Sasha7b9Work/A101/README.md

# Astra

## TOOLS

13.02.2025  
* Keil uVision 5.37.0, compiler 6.18 (при компиляции на 6.21 часто случаются зависания
  при определённых условиях (что-то вроде больших значений на входе, которые выходят за пределы экрана)

### SAST Tools

* [PVS-Studio](https://pvs-studio.ru/ru/pvs-studio/?utm_source=website&utm_medium=github&utm_campaign=open_source) - static analyzer for C, C++, C#, and Java code.
