Sasha7b9Work/A101/sources/Display/readme.txt

ASTRA_old.HMI - версия для первого дисплея
ASTRA.HIM - версия для второго (улучшенного) дисплея
