Sasha7b9Work/A101/docs/ТЗ/Команды.docx

При нажатии на экран приходит:

X, “+”, Y,”-“

| 1 (Page0)
01P_ | Кнопка выбора предела (2 mA) | AVP t11
02P_ | Кнопка выбора предела (20 mA) | AVP t12
03P_ | Кнопка выбора предела (200 mA) | AVP t13
04P_ | Кнопка выбора предела (2 A) | AVP t14
05P_ | Кнопка выбора предела (20 A) | AVP t15
06P_ | Кнопка выбора предела (50 A) | AVP t16
0A_ | Режим AVP
0DZ_ | Zero DC. Измеренное до этого значение постоянной составляющей тока принимается за ноль. | t5
0AZ_ | Zero AC. Измеренное до этого значение переменной составляющей тока принимается за ноль | t6
01I_ | Кнопка позволяющая выбрать дополнительные параметры сигнала максимальное значение. Imax. | t7
02I_ | Кнопка позволяющая выбрать дополнительные параметры сигнала минимальное значение. Imin. | t8
03I_ | Кнопка позволяющая выбрать дополнительные параметры сигнала значение от пика до пика. Ipp. | t9
04I_ | Кнопка позволяющая выбрать дополнительные параметры сигнала амплитудное значение. Iamp. | t10
0S_ | Signal. Hежим отображения графиков сигнала и спектра.
0C_ | Colibration
0DC_ | DC | t0
0AC_ | AC | t1
0AD_ | AC+DC | t1, t0
- | символ звездочки *. Он тухнет и зажигается каждые 1,5-2 секунды, что свидетельствует о том, что прибор исправно работает и информация до экрана доходит | t4

| 3 (Page1)
3WP_ | Отображение графика сигнала | s0
3SP_ | Отображение графика спектора | s0
3B0_ | Кнопка Назад с 3 -> 1

| 2 (Page2)
2B0_ | Кнопка Назад с 2 -> 1
21P_ | Кнопка выбора предела (2 mA)
22P_ | Кнопка выбора предела (20 mA)
23P_ | Кнопка выбора предела (200 mA)
24P_ | Кнопка выбора предела (2 A)
25P_ | Кнопка выбора предела (20 A)
26P_ | Кнопка выбора предела (50 A)
2D1_ | Клавиши выбора номера точки Dot 1
2D2_ | Клавиши выбора номера точки Dot 2
KB0_ | Клавиши цифровой клавиатуры: 0 | t1
KB1_ | Клавиши цифровой клавиатуры: 1 | t1
KB2_ | Клавиши цифровой клавиатуры: 2 | t1
KB3_ | Клавиши цифровой клавиатуры: 3 | t1
KB4_ | Клавиши цифровой клавиатуры: 4 | t1
KB5_ | Клавиши цифровой клавиатуры: 5 | t1
KB6_ | Клавиши цифровой клавиатуры: 6 | t1
KB7_ | Клавиши цифровой клавиатуры: 7 | t1
KB8_ | Клавиши цифровой клавиатуры: 8 | t1
KB9_ | Клавиши цифровой клавиатуры: 9 | t1
KBD_ | Клавиши запятой. | t1
KBS_ | Клавиши смены знака. | t6
- | Поле служит для вывода измеренных значений | t0
2SV_ | Нажать кнопку SAVE. В результате чего на основании ранее сохраненных значений рассчитываются необходимые коэффициенты калибровки для данного диапазона. Эти коэффициенты учитываются в режиме измерения
2OK_ | Нажать кнопку OK. В результате чего в памяти сохраняться значения силы тока измеренного и эталонного для данной точки
2DE_ | Переход на страницу отладки
| Page Debug
4B0_ | Назад – на страницу калибровки
