Sasha7b9Work/A101/docs/version_history.txt

- новая функциональность
* исправление
! схемные изменения

13.02.2025
    538
* Вернулись на версию 6.18 компилятора, потому что на 6.21 зависания

12.02.2025
    537
! Изменена полярность бита US9 PB14 PIN_ZERO. Последний номер прибора со старой полярностью - 17

21.09.2024
    0.1.110
- Правильно измеряются Imin, Imax, Ipp
    0.1.112
* Знаки дополнительных измерений правильно отрабатывают на дисплее
