Sasha7b9Work/A101/samples/arm_fir_example/ARMCM4_debug/arm_fir_example.htm

# Static Call Graph for image .\ARMCM4_debug\arm_fir_example.axf

#<CALLGRAPH># ARM Linker, 6160001: Last Updated: Mon Feb 12 09:05:09 2024

### Maximum Stack Usage = 216 bytes + Unknown(Functions without stacksize, Cycles, Untraceable Function Pointers)

### Call chain for Maximum Stack Depth:

__rt_entry_main ⇒ main ⇒ arm_snr_f32 ⇒ __hardfp_log10 ⇒ log ⇒ __hardfp_log ⇒ __kernel_poly ⇒ __aeabi_dmul

### Functions with no stack information

- __user_initial_stackheap

### Mutually Recursive functions

- NMI_Handler ⇒ NMI_Handler
- HardFault_Handler ⇒ HardFault_Handler
- MemManage_Handler ⇒ MemManage_Handler
- BusFault_Handler ⇒ BusFault_Handler
- UsageFault_Handler ⇒ UsageFault_Handler
- SVC_Handler ⇒ SVC_Handler
- DebugMon_Handler ⇒ DebugMon_Handler
- PendSV_Handler ⇒ PendSV_Handler
- SysTick_Handler ⇒ SysTick_Handler
- ADC_IRQHandler ⇒ ADC_IRQHandler

### Function Pointers

- ADC_IRQHandler from startup_stm32f407xx.o(.text) referenced from startup_stm32f407xx.o(RESET)
- BusFault_Handler from startup_stm32f407xx.o(.text) referenced from startup_stm32f407xx.o(RESET)
- CAN1_RX0_IRQHandler from startup_stm32f407xx.o(.text) referenced from startup_stm32f407xx.o(RESET)
- CAN1_RX1_IRQHandler from startup_stm32f407xx.o(.text) referenced from startup_stm32f407xx.o(RESET)
- CAN1_SCE_IRQHandler from startup_stm32f407xx.o(.text) referenced from startup_stm32f407xx.o(RESET)
- CAN1_TX_IRQHandler from startup_stm32f407xx.o(.text) referenced from startup_stm32f407xx.o(RESET)
- CAN2_RX0_IRQHandler from startup_stm32f407xx.o(.text) referenced from startup_stm32f407xx.o(RESET)
- CAN2_RX1_IRQHandler from startup_stm32f407xx.o(.text) referenced from startup_stm32f407xx.o(RESET)
- CAN2_SCE_IRQHandler from startup_stm32f407xx.o(.text) referenced from startup_stm32f407xx.o(RESET)
- CAN2_TX_IRQHandler from startup_stm32f407xx.o(.text) referenced from startup_stm32f407xx.o(RESET)
- DCMI_IRQHandler from startup_stm32f407xx.o(.text) referenced from startup_stm32f407xx.o(RESET)
- DMA1_Stream0_IRQHandler from startup_stm32f407xx.o(.text) referenced from startup_stm32f407xx.o(RESET)
- DMA1_Stream1_IRQHandler from startup_stm32f407xx.o(.text) referenced from startup_stm32f407xx.o(RESET)
- DMA1_Stream2_IRQHandler from startup_stm32f407xx.o(.text) referenced from startup_stm32f407xx.o(RESET)
- DMA1_Stream3_IRQHandler from startup_stm32f407xx.o(.text) referenced from startup_stm32f407xx.o(RESET)
- DMA1_Stream4_IRQHandler from startup_stm32f407xx.o(.text) referenced from startup_stm32f407xx.o(RESET)
- DMA1_Stream5_IRQHandler from startup_stm32f407xx.o(.text) referenced from startup_stm32f407xx.o(RESET)
- DMA1_Stream6_IRQHandler from startup_stm32f407xx.o(.text) referenced from startup_stm32f407xx.o(RESET)
- DMA1_Stream7_IRQHandler from startup_stm32f407xx.o(.text) referenced from startup_stm32f407xx.o(RESET)
- DMA2_Stream0_IRQHandler from startup_stm32f407xx.o(.text) referenced from startup_stm32f407xx.o(RESET)
- DMA2_Stream1_IRQHandler from startup_stm32f407xx.o(.text) referenced from startup_stm32f407xx.o(RESET)
- DMA2_Stream2_IRQHandler from startup_stm32f407xx.o(.text) referenced from startup_stm32f407xx.o(RESET)
- DMA2_Stream3_IRQHandler from startup_stm32f407xx.o(.text) referenced from startup_stm32f407xx.o(RESET)
- DMA2_Stream4_IRQHandler from startup_stm32f407xx.o(.text) referenced from startup_stm32f407xx.o(RESET)
- DMA2_Stream5_IRQHandler from startup_stm32f407xx.o(.text) referenced from startup_stm32f407xx.o(RESET)
- DMA2_Stream6_IRQHandler from startup_stm32f407xx.o(.text) referenced from startup_stm32f407xx.o(RESET)
- DMA2_Stream7_IRQHandler from startup_stm32f407xx.o(.text) referenced from startup_stm32f407xx.o(RESET)
- DebugMon_Handler from startup_stm32f407xx.o(.text) referenced from startup_stm32f407xx.o(RESET)
- ETH_IRQHandler from startup_stm32f407xx.o(.text) referenced from startup_stm32f407xx.o(RESET)
- ETH_WKUP_IRQHandler from startup_stm32f407xx.o(.text) referenced from startup_stm32f407xx.o(RESET)
- EXTI0_IRQHandler from startup_stm32f407xx.o(.text) referenced from startup_stm32f407xx.o(RESET)
- EXTI15_10_IRQHandler from startup_stm32f407xx.o(.text) referenced from startup_stm32f407xx.o(RESET)
- EXTI1_IRQHandler from startup_stm32f407xx.o(.text) referenced from startup_stm32f407xx.o(RESET)
- EXTI2_IRQHandler from startup_stm32f407xx.o(.text) referenced from startup_stm32f407xx.o(RESET)
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
- TIM4_IRQHandler from startup_stm32f407xx.o(.text) referenced from startup_stm32f407xx.o(RESET)
- TIM5_IRQHandler from startup_stm32f407xx.o(.text) referenced from startup_stm32f407xx.o(RESET)
- TIM6_DAC_IRQHandler from startup_stm32f407xx.o(.text) referenced from startup_stm32f407xx.o(RESET)
- TIM7_IRQHandler from startup_stm32f407xx.o(.text) referenced from startup_stm32f407xx.o(RESET)
- TIM8_BRK_TIM12_IRQHandler from startup_stm32f407xx.o(.text) referenced from startup_stm32f407xx.o(RESET)
- TIM8_CC_IRQHandler from startup_stm32f407xx.o(.text) referenced from startup_stm32f407xx.o(RESET)
- TIM8_TRG_COM_TIM14_IRQHandler from startup_stm32f407xx.o(.text) referenced from startup_stm32f407xx.o(RESET)
- TIM8_UP_TIM13_IRQHandler from startup_stm32f407xx.o(.text) referenced from startup_stm32f407xx.o(RESET)
- UART4_IRQHandler from startup_stm32f407xx.o(.text) referenced from startup_stm32f407xx.o(RESET)
- UART5_IRQHandler from startup_stm32f407xx.o(.text) referenced from startup_stm32f407xx.o(RESET)
- USART1_IRQHandler from startup_stm32f407xx.o(.text) referenced from startup_stm32f407xx.o(RESET)
- USART2_IRQHandler from startup_stm32f407xx.o(.text) referenced from startup_stm32f407xx.o(RESET)
- USART3_IRQHandler from startup_stm32f407xx.o(.text) referenced from startup_stm32f407xx.o(RESET)
- USART6_IRQHandler from startup_stm32f407xx.o(.text) referenced from startup_stm32f407xx.o(RESET)
- UsageFault_Handler from startup_stm32f407xx.o(.text) referenced from startup_stm32f407xx.o(RESET)
- WWDG_IRQHandler from startup_stm32f407xx.o(.text) referenced from startup_stm32f407xx.o(RESET)
- __main from __main.o(!!!main) referenced from startup_stm32f407xx.o(.text)

### Global Symbols

__main (Thumb, 8 bytes, Stack size 0 bytes, __main.o(!!!main))

[Calls]

- >> __scatterload
- >> __rt_entry

[Address Reference Count : 1]

- startup_stm32f407xx.o(.text)

__scatterload (Thumb, 0 bytes, Stack size unknown bytes, __scatter.o(!!!scatter))

[Called By]

- >> __main

__scatterload_rt2 (Thumb, 44 bytes, Stack size unknown bytes, __scatter.o(!!!scatter), UNUSED)

[Calls]

- >> __rt_entry

__scatterload_rt2_thumb_only (Thumb, 0 bytes, Stack size unknown bytes, __scatter.o(!!!scatter), UNUSED)

__scatterload_null (Thumb, 0 bytes, Stack size unknown bytes, __scatter.o(!!!scatter), UNUSED)

__decompress (Thumb, 100 bytes, Stack size unknown bytes, __dclz77c.o(!!dclz77c), UNUSED)

__decompress2 (Thumb, 0 bytes, Stack size unknown bytes, __dclz77c.o(!!dclz77c), UNUSED)

__scatterload_zeroinit (Thumb, 28 bytes, Stack size unknown bytes, __scatter_zi.o(!!handler_zi), UNUSED)

__rt_lib_init (Thumb, 0 bytes, Stack size unknown bytes, libinit.o(.ARM.Collect$$libinit$$00000000))

[Called By]

- >> __rt_entry_li

__rt_lib_init_fp_1 (Thumb, 0 bytes, Stack size unknown bytes, libinit2.o(.ARM.Collect$$libinit$$00000001))

[Calls]

- >> _fp_init

__rt_lib_init_alloca_1 (Thumb, 0 bytes, Stack size unknown bytes, libinit2.o(.ARM.Collect$$libinit$$0000002E))

__rt_lib_init_argv_1 (Thumb, 0 bytes, Stack size unknown bytes, libinit2.o(.ARM.Collect$$libinit$$0000002C))

__rt_lib_init_atexit_1 (Thumb, 0 bytes, Stack size unknown bytes, libinit2.o(.ARM.Collect$$libinit$$0000001B))

__rt_lib_init_clock_1 (Thumb, 0 bytes, Stack size unknown bytes, libinit2.o(.ARM.Collect$$libinit$$00000021))

__rt_lib_init_cpp_1 (Thumb, 0 bytes, Stack size unknown bytes, libinit2.o(.ARM.Collect$$libinit$$00000032))

__rt_lib_init_exceptions_1 (Thumb, 0 bytes, Stack size unknown bytes, libinit2.o(.ARM.Collect$$libinit$$00000030))

__rt_lib_init_fp_trap_1 (Thumb, 0 bytes, Stack size unknown bytes, libinit2.o(.ARM.Collect$$libinit$$0000001F))

__rt_lib_init_getenv_1 (Thumb, 0 bytes, Stack size unknown bytes, libinit2.o(.ARM.Collect$$libinit$$00000023))

__rt_lib_init_heap_1 (Thumb, 0 bytes, Stack size unknown bytes, libinit2.o(.ARM.Collect$$libinit$$0000000A))

__rt_lib_init_lc_collate_1 (Thumb, 0 bytes, Stack size unknown bytes, libinit2.o(.ARM.Collect$$libinit$$00000011))

__rt_lib_init_lc_ctype_1 (Thumb, 0 bytes, Stack size unknown bytes, libinit2.o(.ARM.Collect$$libinit$$00000013))

__rt_lib_init_lc_monetary_1 (Thumb, 0 bytes, Stack size unknown bytes, libinit2.o(.ARM.Collect$$libinit$$00000015))

__rt_lib_init_lc_numeric_1 (Thumb, 0 bytes, Stack size unknown bytes, libinit2.o(.ARM.Collect$$libinit$$00000017))

__rt_lib_init_lc_time_1 (Thumb, 0 bytes, Stack size unknown bytes, libinit2.o(.ARM.Collect$$libinit$$00000019))

__rt_lib_init_preinit_1 (Thumb, 0 bytes, Stack size unknown bytes, libinit2.o(.ARM.Collect$$libinit$$00000004))

__rt_lib_init_rand_1 (Thumb, 0 bytes, Stack size unknown bytes, libinit2.o(.ARM.Collect$$libinit$$0000000E))

__rt_lib_init_return (Thumb, 0 bytes, Stack size unknown bytes, libinit2.o(.ARM.Collect$$libinit$$00000033))

__rt_lib_init_signal_1 (Thumb, 0 bytes, Stack size unknown bytes, libinit2.o(.ARM.Collect$$libinit$$0000001D))

__rt_lib_init_stdio_1 (Thumb, 0 bytes, Stack size unknown bytes, libinit2.o(.ARM.Collect$$libinit$$00000025))

__rt_lib_init_user_alloc_1 (Thumb, 0 bytes, Stack size unknown bytes, libinit2.o(.ARM.Collect$$libinit$$0000000C))

__rt_lib_shutdown (Thumb, 0 bytes, Stack size unknown bytes, libshutdown.o(.ARM.Collect$$libshutdown$$00000000))

[Called By]

- >> __rt_exit_ls

__rt_lib_shutdown_cpp_1 (Thumb, 0 bytes, Stack size unknown bytes, libshutdown2.o(.ARM.Collect$$libshutdown$$00000002))

__rt_lib_shutdown_fp_trap_1 (Thumb, 0 bytes, Stack size unknown bytes, libshutdown2.o(.ARM.Collect$$libshutdown$$00000007))

__rt_lib_shutdown_heap_1 (Thumb, 0 bytes, Stack size unknown bytes, libshutdown2.o(.ARM.Collect$$libshutdown$$0000000F))

__rt_lib_shutdown_return (Thumb, 0 bytes, Stack size unknown bytes, libshutdown2.o(.ARM.Collect$$libshutdown$$00000010))

__rt_lib_shutdown_signal_1 (Thumb, 0 bytes, Stack size unknown bytes, libshutdown2.o(.ARM.Collect$$libshutdown$$0000000A))

__rt_lib_shutdown_stdio_1 (Thumb, 0 bytes, Stack size unknown bytes, libshutdown2.o(.ARM.Collect$$libshutdown$$00000004))

__rt_lib_shutdown_user_alloc_1 (Thumb, 0 bytes, Stack size unknown bytes, libshutdown2.o(.ARM.Collect$$libshutdown$$0000000C))

__rt_entry (Thumb, 0 bytes, Stack size unknown bytes, __rtentry.o(.ARM.Collect$$rtentry$$00000000))

[Called By]

- >> __scatterload_rt2
- >> __main

__rt_entry_presh_1 (Thumb, 0 bytes, Stack size unknown bytes, __rtentry2.o(.ARM.Collect$$rtentry$$00000002))

__rt_entry_sh (Thumb, 0 bytes, Stack size unknown bytes, __rtentry4.o(.ARM.Collect$$rtentry$$00000004))

[Stack]

- Max Depth = 8 + Unknown Stack Size
- Call Chain = __rt_entry_sh ⇒ __user_setup_stackheap

[Calls]

- >> __user_setup_stackheap

__rt_entry_li (Thumb, 0 bytes, Stack size unknown bytes, __rtentry2.o(.ARM.Collect$$rtentry$$0000000A))

[Calls]

- >> __rt_lib_init

__rt_entry_postsh_1 (Thumb, 0 bytes, Stack size unknown bytes, __rtentry2.o(.ARM.Collect$$rtentry$$00000009))

__rt_entry_main (Thumb, 0 bytes, Stack size unknown bytes, __rtentry2.o(.ARM.Collect$$rtentry$$0000000D))

[Stack]

- Max Depth = 216 + Unknown Stack Size
- Call Chain = __rt_entry_main ⇒ main ⇒ arm_snr_f32 ⇒ __hardfp_log10 ⇒ log ⇒ __hardfp_log ⇒ __kernel_poly ⇒ __aeabi_dmul

[Calls]

- >> exit
- >> main

__rt_entry_postli_1 (Thumb, 0 bytes, Stack size unknown bytes, __rtentry2.o(.ARM.Collect$$rtentry$$0000000C))

__rt_exit (Thumb, 0 bytes, Stack size unknown bytes, rtexit.o(.ARM.Collect$$rtexit$$00000000))

[Called By]

- >> exit

__rt_exit_ls (Thumb, 0 bytes, Stack size unknown bytes, rtexit2.o(.ARM.Collect$$rtexit$$00000003))

[Calls]

- >> __rt_lib_shutdown

__rt_exit_prels_1 (Thumb, 0 bytes, Stack size unknown bytes, rtexit2.o(.ARM.Collect$$rtexit$$00000002))

__rt_exit_exit (Thumb, 0 bytes, Stack size unknown bytes, rtexit2.o(.ARM.Collect$$rtexit$$00000004))

[Calls]

- >> _sys_exit

arm_snr_f32 (Thumb, 164 bytes, Stack size 8 bytes, math_helper.o(.text))

[Stack]

- Max Depth = 200
- Call Chain = arm_snr_f32 ⇒ __hardfp_log10 ⇒ log ⇒ __hardfp_log ⇒ __kernel_poly ⇒ __aeabi_dmul

[Calls]

- >> __hardfp_log10
- >> __aeabi_f2d
- >> __aeabi_dmul
- >> __aeabi_d2f

[Called By]

- >> main

arm_provide_guard_bits_q15 (Thumb, 24 bytes, Stack size 0 bytes, math_helper.o(.text), UNUSED)

arm_float_to_q12_20 (Thumb, 140 bytes, Stack size 56 bytes, math_helper.o(.text), UNUSED)

[Calls]

- >> __aeabi_i2d
- >> __aeabi_d2iz
- >> __aeabi_dadd

arm_compare_fixed_q15 (Thumb, 48 bytes, Stack size 8 bytes, math_helper.o(.text), UNUSED)

arm_compare_fixed_q31 (Thumb, 48 bytes, Stack size 8 bytes, math_helper.o(.text), UNUSED)

arm_provide_guard_bits_q31 (Thumb, 24 bytes, Stack size 0 bytes, math_helper.o(.text), UNUSED)

arm_provide_guard_bits_q7 (Thumb, 24 bytes, Stack size 0 bytes, math_helper.o(.text), UNUSED)

arm_calc_guard_bits (Thumb, 30 bytes, Stack size 0 bytes, math_helper.o(.text), UNUSED)

arm_apply_guard_bits (Thumb, 50 bytes, Stack size 16 bytes, math_helper.o(.text), UNUSED)

[Calls]

- >> arm_calc_2pow

arm_calc_2pow (Thumb, 22 bytes, Stack size 0 bytes, math_helper.o(.text), UNUSED)

[Called By]

- >> arm_apply_guard_bits

arm_float_to_q14 (Thumb, 140 bytes, Stack size 56 bytes, math_helper.o(.text), UNUSED)

[Calls]

- >> __aeabi_i2d
- >> __aeabi_d2iz
- >> __aeabi_dadd

arm_float_to_q30 (Thumb, 140 bytes, Stack size 56 bytes, math_helper.o(.text), UNUSED)

[Calls]

- >> __aeabi_i2d
- >> __aeabi_d2iz
- >> __aeabi_dadd

arm_float_to_q29 (Thumb, 140 bytes, Stack size 56 bytes, math_helper.o(.text), UNUSED)

[Calls]

- >> __aeabi_i2d
- >> __aeabi_d2iz
- >> __aeabi_dadd

arm_float_to_q28 (Thumb, 140 bytes, Stack size 56 bytes, math_helper.o(.text), UNUSED)

[Calls]

- >> __aeabi_i2d
- >> __aeabi_d2iz
- >> __aeabi_dadd

main (Thumb, 172 bytes, Stack size 16 bytes, arm_fir_example_f32.o(.text))

[Stack]

- Max Depth = 216 + Unknown Stack Size
- Call Chain = main ⇒ arm_snr_f32 ⇒ __hardfp_log10 ⇒ log ⇒ __hardfp_log ⇒ __kernel_poly ⇒ __aeabi_dmul

[Calls]

- >> arm_fir_init_f32
- >> arm_fir_f32
- >> arm_snr_f32

[Called By]

- >> __rt_entry_main

Reset_Handler (Thumb, 8 bytes, Stack size 0 bytes, startup_stm32f407xx.o(.text))
[Address Reference Count : 1]

- startup_stm32f407xx.o(RESET)

NMI_Handler (Thumb, 2 bytes, Stack size 0 bytes, startup_stm32f407xx.o(.text))

[Calls]

- >> NMI_Handler

[Called By]

- >> NMI_Handler

[Address Reference Count : 1]

- startup_stm32f407xx.o(RESET)

HardFault_Handler (Thumb, 2 bytes, Stack size 0 bytes, startup_stm32f407xx.o(.text))

[Calls]

- >> HardFault_Handler

[Called By]

- >> HardFault_Handler

[Address Reference Count : 1]

- startup_stm32f407xx.o(RESET)

MemManage_Handler (Thumb, 2 bytes, Stack size 0 bytes, startup_stm32f407xx.o(.text))

[Calls]

- >> MemManage_Handler

[Called By]

- >> MemManage_Handler

[Address Reference Count : 1]

- startup_stm32f407xx.o(RESET)

BusFault_Handler (Thumb, 2 bytes, Stack size 0 bytes, startup_stm32f407xx.o(.text))

[Calls]

- >> BusFault_Handler

[Called By]

- >> BusFault_Handler

[Address Reference Count : 1]

- startup_stm32f407xx.o(RESET)

UsageFault_Handler (Thumb, 2 bytes, Stack size 0 bytes, startup_stm32f407xx.o(.text))

[Calls]

- >> UsageFault_Handler

[Called By]

- >> UsageFault_Handler

[Address Reference Count : 1]

- startup_stm32f407xx.o(RESET)

SVC_Handler (Thumb, 2 bytes, Stack size 0 bytes, startup_stm32f407xx.o(.text))

[Calls]

- >> SVC_Handler

[Called By]

- >> SVC_Handler

[Address Reference Count : 1]

- startup_stm32f407xx.o(RESET)

DebugMon_Handler (Thumb, 2 bytes, Stack size 0 bytes, startup_stm32f407xx.o(.text))

[Calls]

- >> DebugMon_Handler

[Called By]

- >> DebugMon_Handler

[Address Reference Count : 1]

- startup_stm32f407xx.o(RESET)

PendSV_Handler (Thumb, 2 bytes, Stack size 0 bytes, startup_stm32f407xx.o(.text))

[Calls]

- >> PendSV_Handler

[Called By]

- >> PendSV_Handler

[Address Reference Count : 1]

- startup_stm32f407xx.o(RESET)

SysTick_Handler (Thumb, 2 bytes, Stack size 0 bytes, startup_stm32f407xx.o(.text))

[Calls]

- >> SysTick_Handler

[Called By]

- >> SysTick_Handler

[Address Reference Count : 1]

- startup_stm32f407xx.o(RESET)

ADC_IRQHandler (Thumb, 0 bytes, Stack size 0 bytes, startup_stm32f407xx.o(.text))

[Calls]

- >> ADC_IRQHandler

[Called By]

- >> ADC_IRQHandler

[Address Reference Count : 1]

- startup_stm32f407xx.o(RESET)

CAN1_RX0_IRQHandler (Thumb, 0 bytes, Stack size 0 bytes, startup_stm32f407xx.o(.text))
[Address Reference Count : 1]

- startup_stm32f407xx.o(RESET)

CAN1_RX1_IRQHandler (Thumb, 0 bytes, Stack size 0 bytes, startup_stm32f407xx.o(.text))
[Address Reference Count : 1]

- startup_stm32f407xx.o(RESET)

CAN1_SCE_IRQHandler (Thumb, 0 bytes, Stack size 0 bytes, startup_stm32f407xx.o(.text))
[Address Reference Count : 1]

- startup_stm32f407xx.o(RESET)

CAN1_TX_IRQHandler (Thumb, 0 bytes, Stack size 0 bytes, startup_stm32f407xx.o(.text))
[Address Reference Count : 1]

- startup_stm32f407xx.o(RESET)

CAN2_RX0_IRQHandler (Thumb, 0 bytes, Stack size 0 bytes, startup_stm32f407xx.o(.text))
[Address Reference Count : 1]

- startup_stm32f407xx.o(RESET)

CAN2_RX1_IRQHandler (Thumb, 0 bytes, Stack size 0 bytes, startup_stm32f407xx.o(.text))
[Address Reference Count : 1]

- startup_stm32f407xx.o(RESET)

CAN2_SCE_IRQHandler (Thumb, 0 bytes, Stack size 0 bytes, startup_stm32f407xx.o(.text))
[Address Reference Count : 1]

- startup_stm32f407xx.o(RESET)

CAN2_TX_IRQHandler (Thumb, 0 bytes, Stack size 0 bytes, startup_stm32f407xx.o(.text))
[Address Reference Count : 1]

- startup_stm32f407xx.o(RESET)

DCMI_IRQHandler (Thumb, 0 bytes, Stack size 0 bytes, startup_stm32f407xx.o(.text))
[Address Reference Count : 1]

- startup_stm32f407xx.o(RESET)

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

USART2_IRQHandler (Thumb, 0 bytes, Stack size 0 bytes, startup_stm32f407xx.o(.text))
[Address Reference Count : 1]

- startup_stm32f407xx.o(RESET)

USART3_IRQHandler (Thumb, 0 bytes, Stack size 0 bytes, startup_stm32f407xx.o(.text))
[Address Reference Count : 1]

- startup_stm32f407xx.o(RESET)

USART6_IRQHandler (Thumb, 0 bytes, Stack size 0 bytes, startup_stm32f407xx.o(.text))
[Address Reference Count : 1]

- startup_stm32f407xx.o(RESET)

WWDG_IRQHandler (Thumb, 0 bytes, Stack size 0 bytes, startup_stm32f407xx.o(.text))
[Address Reference Count : 1]

- startup_stm32f407xx.o(RESET)

__user_initial_stackheap (Thumb, 0 bytes, Stack size unknown bytes, startup_stm32f407xx.o(.text))

[Called By]

- >> __user_setup_stackheap

SystemInit (Thumb, 18 bytes, Stack size 0 bytes, system_stm32f4xx.o(.text))
[Address Reference Count : 1]

- startup_stm32f407xx.o(.text)

SystemCoreClockUpdate (Thumb, 126 bytes, Stack size 0 bytes, system_stm32f4xx.o(.text), UNUSED)

arm_fir_f32 (Thumb, 1216 bytes, Stack size 88 bytes, arm_fir_f32.o(.text))

[Stack]

- Max Depth = 88
- Call Chain = arm_fir_f32

[Called By]

- >> main

arm_fir_init_f32 (Thumb, 32 bytes, Stack size 16 bytes, arm_fir_init_f32.o(.text))

[Stack]

- Max Depth = 16 + Unknown Stack Size
- Call Chain = arm_fir_init_f32

[Calls]

- >> __aeabi_memclr4

[Called By]

- >> main

__aeabi_memclr4 (Thumb, 0 bytes, Stack size unknown bytes, rt_memclr_w.o(.text))

[Called By]

- >> arm_fir_init_f32

__aeabi_memclr8 (Thumb, 0 bytes, Stack size unknown bytes, rt_memclr_w.o(.text), UNUSED)

__rt_memclr_w (Thumb, 0 bytes, Stack size unknown bytes, rt_memclr_w.o(.text), UNUSED)

_memset_w (Thumb, 74 bytes, Stack size 4 bytes, rt_memclr_w.o(.text), UNUSED)

__use_two_region_memory (Thumb, 2 bytes, Stack size 0 bytes, heapauxi.o(.text), UNUSED)

__rt_heap_escrow$2region (Thumb, 2 bytes, Stack size 0 bytes, heapauxi.o(.text), UNUSED)

__rt_heap_expand$2region (Thumb, 2 bytes, Stack size 0 bytes, heapauxi.o(.text), UNUSED)

__read_errno (Thumb, 10 bytes, Stack size 8 bytes, _rserrno.o(.text), UNUSED)

[Calls]

- >> __aeabi_errno_addr

__set_errno (Thumb, 12 bytes, Stack size 8 bytes, _rserrno.o(.text))

[Stack]

- Max Depth = 8
- Call Chain = __set_errno

[Calls]

- >> __aeabi_errno_addr

[Called By]

- >> __hardfp_log
- >> __hardfp_log10

__aeabi_errno_addr (Thumb, 8 bytes, Stack size 0 bytes, rt_errno_addr_intlibspace.o(.text))

[Called By]

- >> __set_errno
- >> __read_errno

__errno$intlibspace (Thumb, 0 bytes, Stack size 0 bytes, rt_errno_addr_intlibspace.o(.text), UNUSED)

__rt_errno_addr$intlibspace (Thumb, 0 bytes, Stack size 0 bytes, rt_errno_addr_intlibspace.o(.text), UNUSED)

__user_libspace (Thumb, 8 bytes, Stack size 0 bytes, libspace.o(.text), UNUSED)

__user_perproc_libspace (Thumb, 0 bytes, Stack size 0 bytes, libspace.o(.text))

[Called By]

- >> __user_setup_stackheap

__user_perthread_libspace (Thumb, 0 bytes, Stack size 0 bytes, libspace.o(.text), UNUSED)

__user_setup_stackheap (Thumb, 74 bytes, Stack size 8 bytes, sys_stackheap_outer.o(.text))

[Stack]

- Max Depth = 8 + Unknown Stack Size
- Call Chain = __user_setup_stackheap

[Calls]

- >> __user_perproc_libspace
- >> __user_initial_stackheap

[Called By]

- >> __rt_entry_sh

exit (Thumb, 18 bytes, Stack size 8 bytes, exit.o(.text))

[Stack]

- Max Depth = 8 + Unknown Stack Size
- Call Chain = exit

[Calls]

- >> __rt_exit

[Called By]

- >> __rt_entry_main

_sys_exit (Thumb, 8 bytes, Stack size 0 bytes, sys_exit.o(.text))

[Called By]

- >> __rt_exit_exit

__I$use$semihosting (Thumb, 0 bytes, Stack size 0 bytes, use_no_semi.o(.text), UNUSED)

__use_no_semihosting_swi (Thumb, 2 bytes, Stack size 0 bytes, use_no_semi.o(.text), UNUSED)

__semihosting_library_function (Thumb, 0 bytes, Stack size unknown bytes, indicate_semi.o(.text), UNUSED)

__hardfp_log (Thumb, 872 bytes, Stack size 88 bytes, log.o(i.__hardfp_log))

[Stack]

- Max Depth = 144
- Call Chain = __hardfp_log ⇒ __kernel_poly ⇒ __aeabi_dmul

[Calls]

- >> __kernel_poly
- >> __aeabi_cdcmpeq
- >> __aeabi_ddiv
- >> __mathlib_dbl_invalid
- >> __mathlib_dbl_infnan
- >> __mathlib_dbl_divzero
- >> __aeabi_dneg
- >> __set_errno
- >> __aeabi_dmul
- >> __aeabi_i2d
- >> __aeabi_dsub
- >> __aeabi_drsub
- >> __aeabi_dadd

[Called By]

- >> log

__hardfp_log10 (Thumb, 260 bytes, Stack size 40 bytes, log10.o(i.__hardfp_log10))

[Stack]

- Max Depth = 192
- Call Chain = __hardfp_log10 ⇒ log ⇒ __hardfp_log ⇒ __kernel_poly ⇒ __aeabi_dmul

[Calls]

- >> log
- >> __mathlib_dbl_invalid
- >> __mathlib_dbl_infnan
- >> __mathlib_dbl_divzero
- >> __aeabi_dneg
- >> __set_errno
- >> __aeabi_dmul
- >> __aeabi_i2d
- >> __aeabi_dadd

[Called By]

- >> arm_snr_f32

__kernel_poly (Thumb, 248 bytes, Stack size 24 bytes, poly.o(i.__kernel_poly))

[Stack]

- Max Depth = 56
- Call Chain = __kernel_poly ⇒ __aeabi_dmul

[Calls]

- >> __aeabi_dmul
- >> __aeabi_dadd

[Called By]

- >> __hardfp_log

__mathlib_dbl_divzero (Thumb, 28 bytes, Stack size 8 bytes, dunder.o(i.__mathlib_dbl_divzero))

[Stack]

- Max Depth = 40
- Call Chain = __mathlib_dbl_divzero ⇒ __aeabi_ddiv

[Calls]

- >> __aeabi_ddiv

[Called By]

- >> __hardfp_log
- >> __hardfp_log10

__mathlib_dbl_infnan (Thumb, 20 bytes, Stack size 8 bytes, dunder.o(i.__mathlib_dbl_infnan))

[Stack]

- Max Depth = 24
- Call Chain = __mathlib_dbl_infnan ⇒ __aeabi_dadd

[Calls]

- >> __aeabi_dadd

[Called By]

- >> __hardfp_log
- >> __hardfp_log10

__mathlib_dbl_invalid (Thumb, 24 bytes, Stack size 8 bytes, dunder.o(i.__mathlib_dbl_invalid))

[Stack]

- Max Depth = 40
- Call Chain = __mathlib_dbl_invalid ⇒ __aeabi_ddiv

[Calls]

- >> __aeabi_ddiv

[Called By]

- >> __hardfp_log
- >> __hardfp_log10

log (Thumb, 16 bytes, Stack size 8 bytes, log.o(i.log))

[Stack]

- Max Depth = 152
- Call Chain = log ⇒ __hardfp_log ⇒ __kernel_poly ⇒ __aeabi_dmul

[Calls]

- >> __hardfp_log

[Called By]

- >> __hardfp_log10

__aeabi_dneg (Thumb, 0 bytes, Stack size 0 bytes, basic.o(x$fpl$basic))

[Called By]

- >> __hardfp_log
- >> __hardfp_log10

_dneg (Thumb, 6 bytes, Stack size 0 bytes, basic.o(x$fpl$basic), UNUSED)

__aeabi_fneg (Thumb, 0 bytes, Stack size 0 bytes, basic.o(x$fpl$basic), UNUSED)

_fneg (Thumb, 6 bytes, Stack size 0 bytes, basic.o(x$fpl$basic), UNUSED)

_dabs (Thumb, 6 bytes, Stack size 0 bytes, basic.o(x$fpl$basic), UNUSED)

_fabs (Thumb, 6 bytes, Stack size 0 bytes, basic.o(x$fpl$basic), UNUSED)

__aeabi_d2f (Thumb, 0 bytes, Stack size 32 bytes, d2f.o(x$fpl$d2f))

[Stack]

- Max Depth = 32
- Call Chain = __aeabi_d2f

[Called By]

- >> arm_snr_f32

_d2f (Thumb, 98 bytes, Stack size 32 bytes, d2f.o(x$fpl$d2f), UNUSED)

[Calls]

- >> __fpl_fretinf
- >> __fpl_dnaninf

__aeabi_dadd (Thumb, 0 bytes, Stack size 16 bytes, daddsub_clz.o(x$fpl$dadd))

[Stack]

- Max Depth = 16
- Call Chain = __aeabi_dadd

[Called By]

- >> __kernel_poly
- >> __hardfp_log
- >> __mathlib_dbl_infnan
- >> __hardfp_log10
- >> arm_float_to_q30
- >> arm_float_to_q29
- >> arm_float_to_q28
- >> arm_float_to_q14
- >> arm_float_to_q12_20

_dadd (Thumb, 332 bytes, Stack size 16 bytes, daddsub_clz.o(x$fpl$dadd), UNUSED)

[Calls]

- >> __fpl_dretinf
- >> __fpl_dnaninf
- >> _dsub1

__fpl_dcmp_Inf (Thumb, 24 bytes, Stack size 0 bytes, dcmpi.o(x$fpl$dcmpinf), UNUSED)

[Called By]

- >> _dcmpeq

__aeabi_ddiv (Thumb, 0 bytes, Stack size 32 bytes, ddiv.o(x$fpl$ddiv))

[Stack]

- Max Depth = 32
- Call Chain = __aeabi_ddiv

[Called By]

- >> __hardfp_log
- >> __mathlib_dbl_invalid
- >> __mathlib_dbl_divzero

_ddiv (Thumb, 556 bytes, Stack size 32 bytes, ddiv.o(x$fpl$ddiv), UNUSED)

[Calls]

- >> __fpl_dretinf
- >> __fpl_dnaninf

__aeabi_cdcmpeq (Thumb, 0 bytes, Stack size 32 bytes, deqf.o(x$fpl$deqf))

[Stack]

- Max Depth = 32
- Call Chain = __aeabi_cdcmpeq

[Called By]

- >> __hardfp_log

_dcmpeq (Thumb, 120 bytes, Stack size 32 bytes, deqf.o(x$fpl$deqf), UNUSED)

[Calls]

- >> __fpl_dcmp_Inf
- >> __fpl_dnaninf

__aeabi_d2iz (Thumb, 0 bytes, Stack size 32 bytes, dfix.o(x$fpl$dfix), UNUSED)

[Called By]

- >> arm_float_to_q30
- >> arm_float_to_q29
- >> arm_float_to_q28
- >> arm_float_to_q14
- >> arm_float_to_q12_20

_dfix (Thumb, 94 bytes, Stack size 32 bytes, dfix.o(x$fpl$dfix), UNUSED)

[Calls]

- >> __fpl_dnaninf

__aeabi_i2d (Thumb, 0 bytes, Stack size 0 bytes, dflt_clz.o(x$fpl$dflt))

[Called By]

- >> __hardfp_log
- >> __hardfp_log10
- >> arm_float_to_q30
- >> arm_float_to_q29
- >> arm_float_to_q28
- >> arm_float_to_q14
- >> arm_float_to_q12_20

_dflt (Thumb, 46 bytes, Stack size 0 bytes, dflt_clz.o(x$fpl$dflt), UNUSED)

__aeabi_dmul (Thumb, 0 bytes, Stack size 32 bytes, dmul.o(x$fpl$dmul))

[Stack]

- Max Depth = 32
- Call Chain = __aeabi_dmul

[Called By]

- >> __kernel_poly
- >> __hardfp_log
- >> __hardfp_log10
- >> arm_snr_f32

_dmul (Thumb, 332 bytes, Stack size 32 bytes, dmul.o(x$fpl$dmul), UNUSED)

[Calls]

- >> __fpl_dretinf
- >> __fpl_dnaninf

__fpl_dnaninf (Thumb, 156 bytes, Stack size 16 bytes, dnaninf.o(x$fpl$dnaninf), UNUSED)

[Called By]

- >> _dcmpeq
- >> _ddiv
- >> _dmul
- >> _dfix
- >> _dsub
- >> _dadd
- >> _d2f

__fpl_dretinf (Thumb, 12 bytes, Stack size 0 bytes, dretinf.o(x$fpl$dretinf), UNUSED)

[Called By]

- >> _ddiv
- >> _f2d
- >> _dmul
- >> _dadd

__aeabi_drsub (Thumb, 0 bytes, Stack size 8 bytes, daddsub_clz.o(x$fpl$drsb))

[Stack]

- Max Depth = 8
- Call Chain = __aeabi_drsub

[Called By]

- >> __hardfp_log

_drsb (Thumb, 22 bytes, Stack size 8 bytes, daddsub_clz.o(x$fpl$drsb), UNUSED)

[Calls]

- >> _dsub1
- >> _dadd1

__aeabi_dsub (Thumb, 0 bytes, Stack size 32 bytes, daddsub_clz.o(x$fpl$dsub))

[Stack]

- Max Depth = 32
- Call Chain = __aeabi_dsub

[Called By]

- >> __hardfp_log

_dsub (Thumb, 472 bytes, Stack size 32 bytes, daddsub_clz.o(x$fpl$dsub), UNUSED)

[Calls]

- >> __fpl_dnaninf
- >> _dadd1

__aeabi_f2d (Thumb, 0 bytes, Stack size 16 bytes, f2d.o(x$fpl$f2d))

[Stack]

- Max Depth = 16
- Call Chain = __aeabi_f2d

[Called By]

- >> arm_snr_f32

_f2d (Thumb, 86 bytes, Stack size 16 bytes, f2d.o(x$fpl$f2d), UNUSED)

[Calls]

- >> __fpl_fnaninf
- >> __fpl_dretinf

__fpl_fnaninf (Thumb, 140 bytes, Stack size 8 bytes, fnaninf.o(x$fpl$fnaninf), UNUSED)

[Called By]

- >> _f2d

_fp_init (Thumb, 26 bytes, Stack size 0 bytes, fpinit.o(x$fpl$fpinit))

[Called By]

- >> __rt_lib_init_fp_1

__fplib_config_fpu_vfp (Thumb, 0 bytes, Stack size unknown bytes, fpinit.o(x$fpl$fpinit), UNUSED)

__fplib_config_pureend_doubles (Thumb, 0 bytes, Stack size unknown bytes, fpinit.o(x$fpl$fpinit), UNUSED)

__fpl_fretinf (Thumb, 10 bytes, Stack size 0 bytes, fretinf.o(x$fpl$fretinf), UNUSED)

[Called By]

- >> _d2f

### Local Symbols

_dadd1 (Thumb, 0 bytes, Stack size unknown bytes, daddsub_clz.o(x$fpl$dadd), UNUSED)

[Called By]

- >> _dsub
- >> _drsb

_dsub1 (Thumb, 0 bytes, Stack size unknown bytes, daddsub_clz.o(x$fpl$dsub), UNUSED)

[Called By]

- >> _drsb
- >> _dadd

### Undefined Global Symbols
