Sasha7b9Work/A101/docs/ТЗ/schematic/Цифровая часть Астра.pdf

### ÓØßÈ.468169.027 Ý3

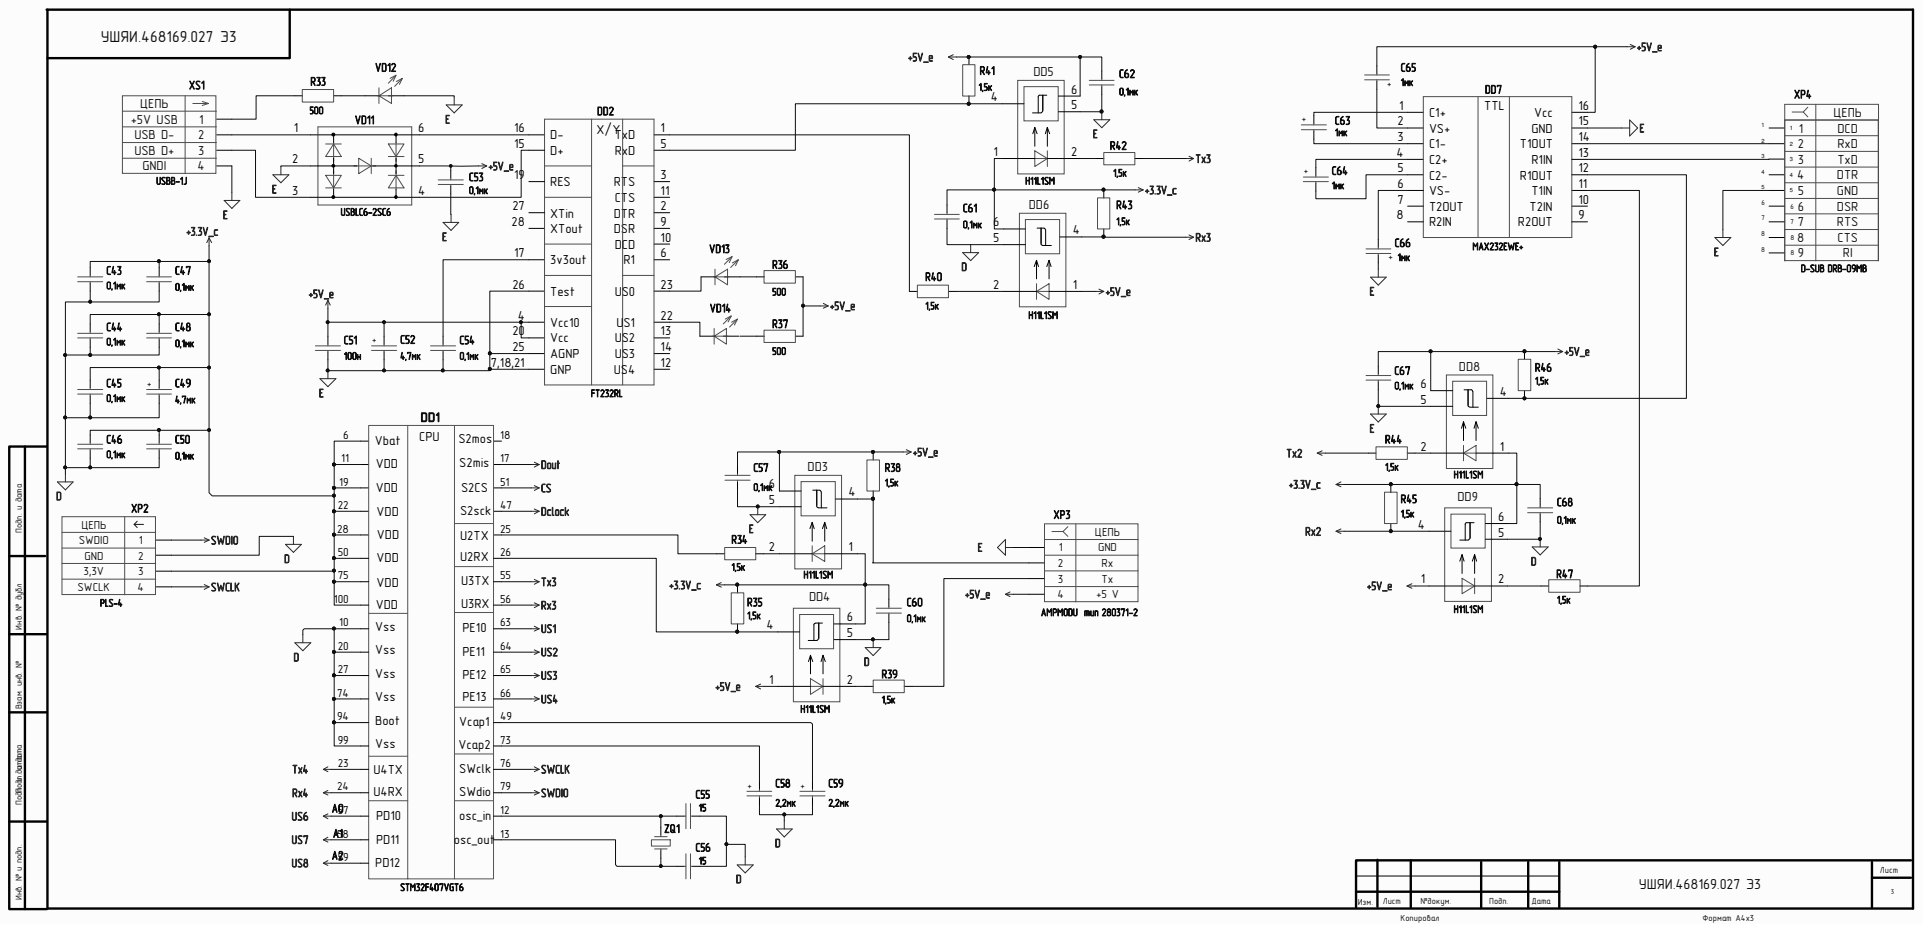
[picture p2: page 1]

C1+ VS+ C1-C2+ C2-VS-T2OUT R2IN | TTL

ÖÅÏÜ

2 2 | RxD

3 3 | TxD

5 5 | GND
6 6 | DSR
7 7 | RTS
8 8 | CTS

Èíâ. ¹ è ïîäï. Ïîäï. è äàòà Âçàì. èíâ. ¹ Èíâ. ¹ äóáë Ïîäï. è äàòà Ïîäï. è äàòà

U4TX U4RX | SWclk SWdio

PD10 PD11 PD12 | osc_in osc_out
