Sasha7b9Work/A101/docs/ТЗ/schematic/Аналоговая часть Астра.pdf

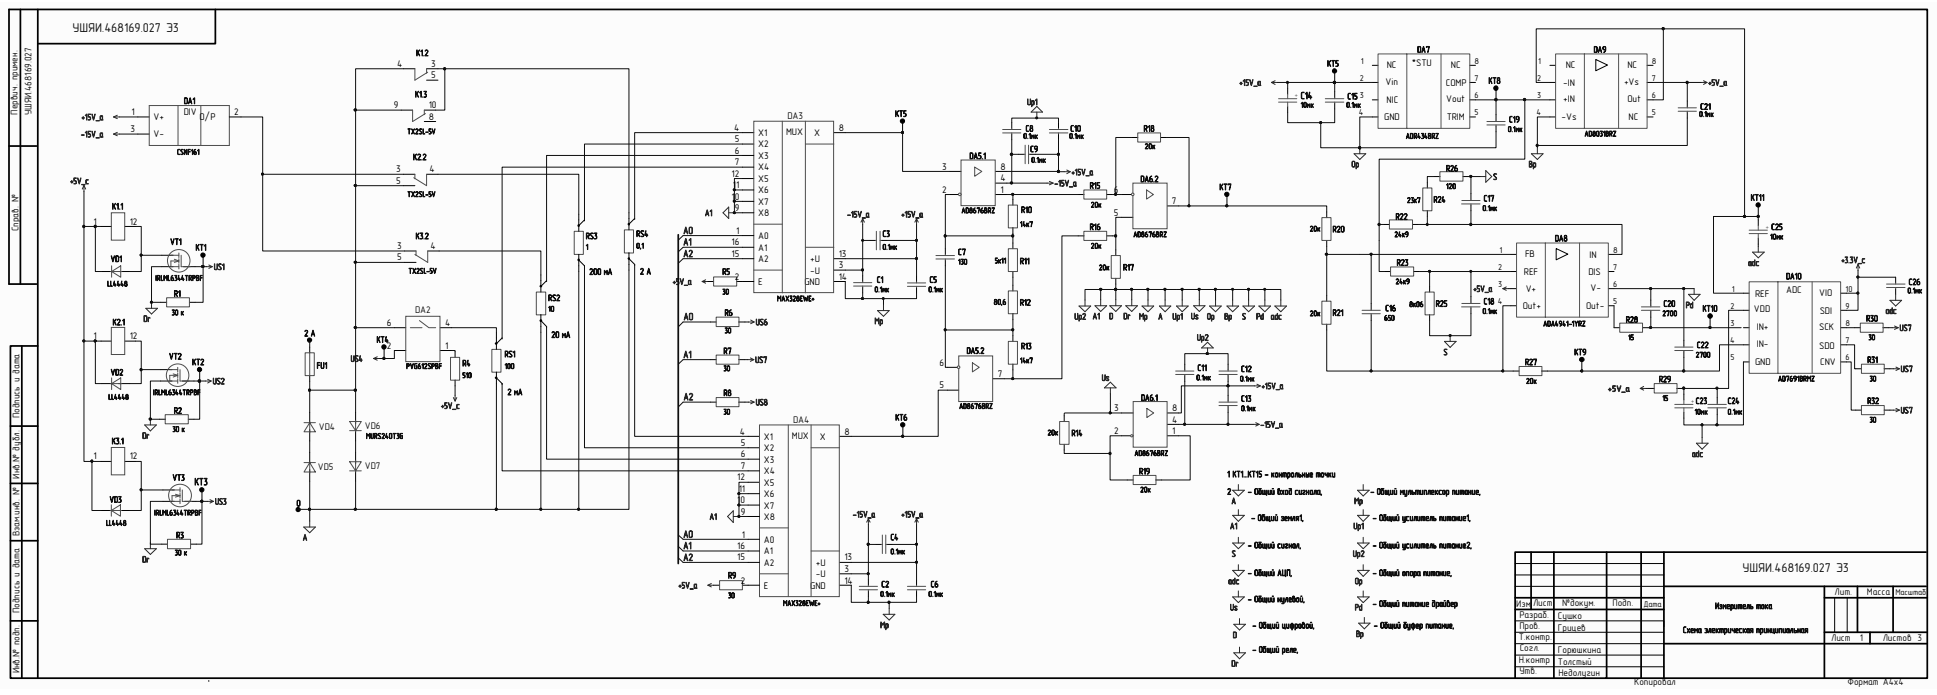
[picture p3: page 1]

Èíâ.¹ äóáë. Ïîäïèñü è äàòà

Èíâ.¹ ïîäï. Ïîäïèñü è äàòà Âçàì.èíâ. ¹ Ëèñò Ïîäï. Ëèñòîâ

Ñõåìà ýëåêòðè÷åñêàÿ ïðèíöèïèàëüíàÿ
