Sasha7b9Work/A101/docs/ТЗ/schematic/Блок питания Астра.pdf

## ÓØßÈ.468169.027 Ý3

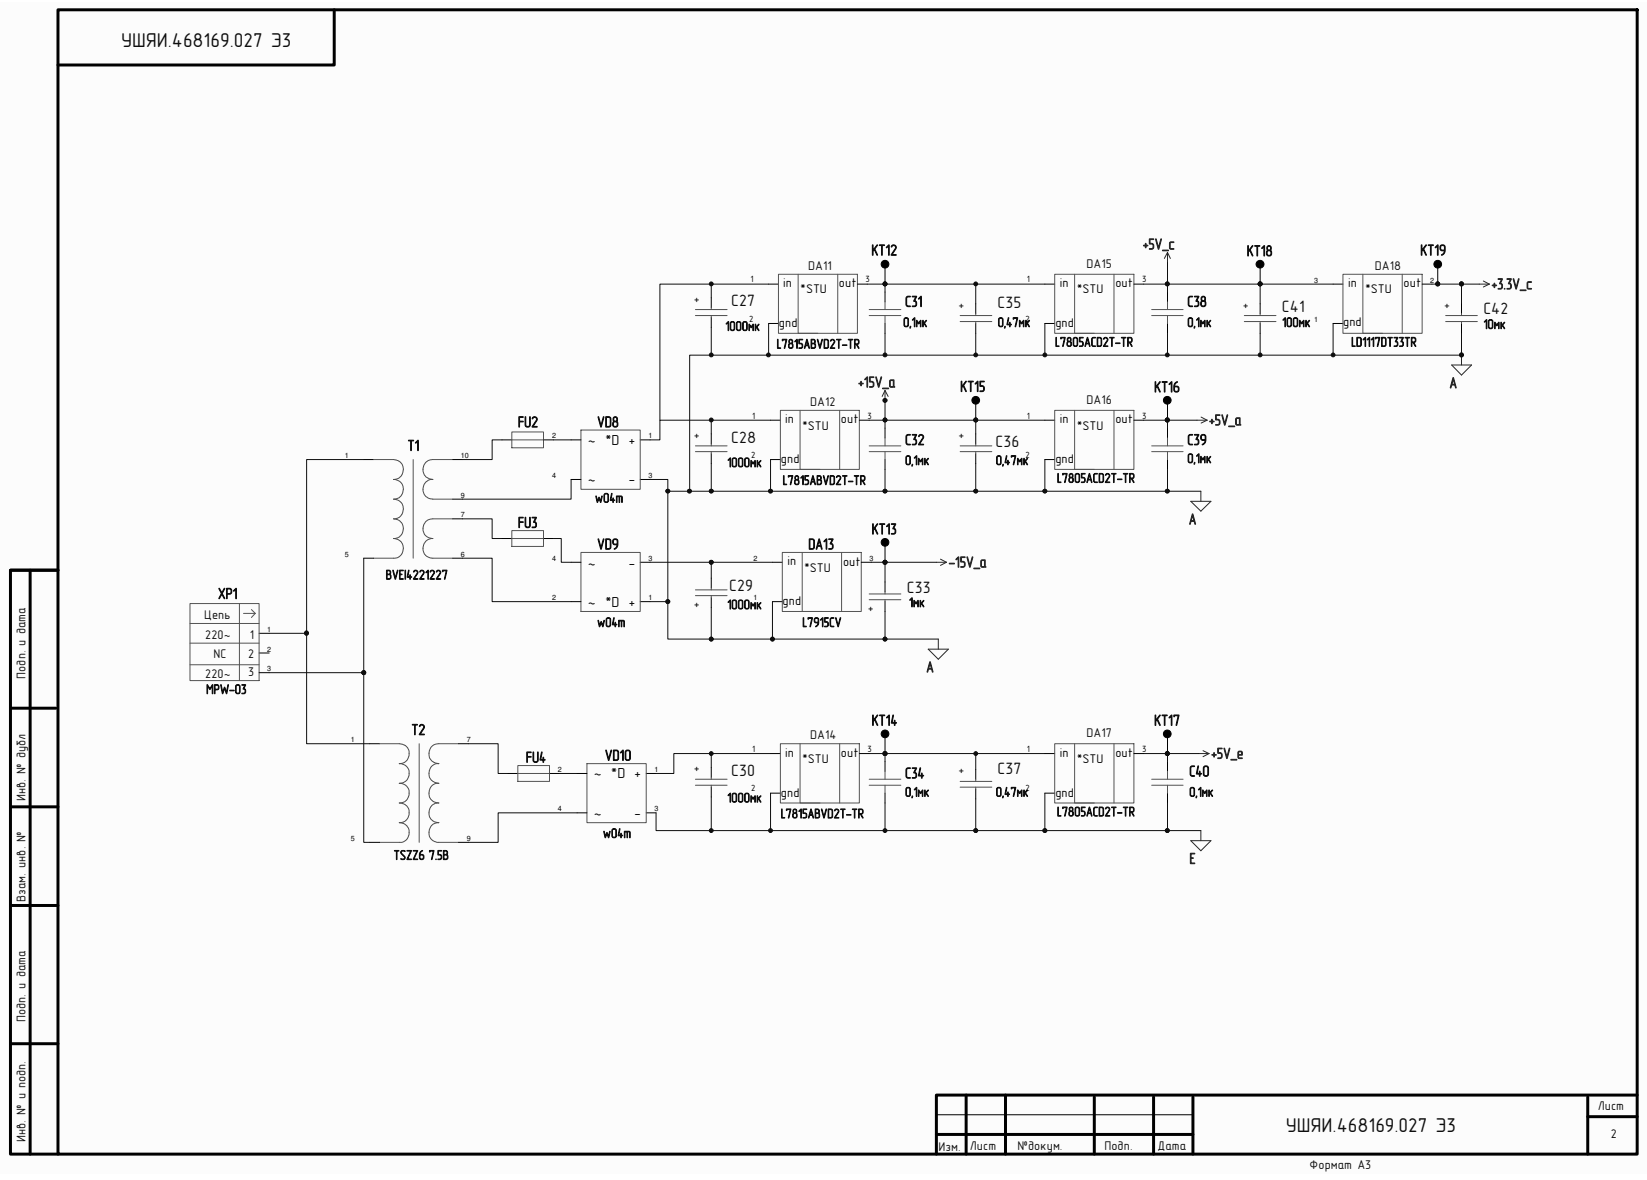
[picture p4: page 1]

Èíâ. ¹ äóáë Ïîäï. è äàòà

Öåïü
220~ | 1
NC | 2
220~ | 3

Èíâ. ¹ è ïîäï. Ïîäï. è äàòà Âçàì. èíâ. ¹ Ëèñò
