Sasha7b9Work/A101/docs/РД/Распиновка/Распиновка.ioc

Mcu.UserName=STM32F407VGTx
PA0-WKUP.Signal=UART4_TX
PA1.Signal=UART4_RX
PA13.Signal=SYS_JTMS-SWDIO
PA14.Signal=SYS_JTCK-SWCLK
PA2.Signal=USART2_TX
PA3.Signal=USART2_RX
PB10.Signal=SPI2_SCK
PB12.Signal=SPI2_NSS
PC2.Signal=SPI2_MISO
PC6.GPIO_Label=US1
PC6.Signal=GPIO_Output
PC7.GPIO_Label=US2
PC7.Signal=GPIO_Output
PC8.GPIO_Label=US3
PC8.Signal=GPIO_Output
PC9.GPIO_Label=US4
PC9.Signal=GPIO_Output
PD10.GPIO_Label=US6
PD10.Signal=GPIO_Output
PD11.GPIO_Label=US7
PD11.Signal=GPIO_Output
PD12.GPIO_Label=US8
PD12.Signal=GPIO_Output
PD8.Signal=USART3_TX
PD9.Signal=USART3_RX
PH0-OSC_IN.Signal=RCC_OSC_IN
PH1-OSC_OUT.Signal=RCC_OSC_OUT
