Sasha7b9Work/A101/sources/VS/Explorer/src/Controls/TextControl.cpp

// (c) Aleksandr Shevchenko e-mail : Sasha7b9@tut.by
#include "defines.h"
#include "Controls/TextControl.h"
#include "Dialogs/Dialog.h"


TextControlInt::TextControlInt(int _min, int _max, wxDialog *dlg, wxWindowID id, const wxString &value, const wxPoint &position, const wxSize &size) : 
    wxTextCtrl(dlg, id, value, position, size), min(_min), max(_max)
{
    Bind(wxEVT_KEY_DOWN, &TextControlInt::OnKeyDown, this);
}


void TextControlInt::OnKeyDown(wxKeyEvent &event)
{
#define SIZE_BUFFER 50

    int code = event.GetKeyCode();

    if (code >= '0' && code <= '9')
    {
        long start = 0;
        long end = 0;

        GetSelection(&start, &end);

        char buffer[SIZE_BUFFER];

        if (end - start != 0)
        {
            buffer[0] = (char)code;
            buffer[1] = 0;

            SetValue("");
            this->AppendText(buffer);

            event.Skip(false);
        }
        else
        {
            std::strcpy(buffer, GetValue().c_str());
            uint length = std::strlen(buffer);
            buffer[length] = (char)code;
            if (length > SIZE_BUFFER - 2) { length = SIZE_BUFFER - 2; }
            buffer[length + 1] = 0;
            int value = atoi(buffer);

            event.Skip(value >= min && value <= max);
        }
    }
    else if (code == WXK_RETURN || code == WXK_BACK || code == WXK_LEFT || code == WXK_RIGHT || code == WXK_TAB || code == WXK_DELETE || code == WXK_INSERT)
    {
        event.Skip(true);
    }
    else
    {
        event.Skip(false);
    }
}


TextControlFloat::TextControlFloat(Dialog *dlg, float _min, float _max, wxWindow *parent, wxWindowID id, const wxString &value, const wxPoint &position, const wxSize &size) :
    wxTextCtrl(parent, id, value, position, size), min(_min), max(_max), dialog(dlg)
{
    Bind(wxEVT_KEY_DOWN, &TextControlFloat::OnKeyDown, this);
}


void TextControlFloat::OnKeyDown(wxKeyEvent &event)
{
    int code = event.GetKeyCode();

    if (code >= '0' && code <= '9' || code == ',')
    {
        long start = 0;
        long end = 0;

        GetSelection(&start, &end);

        char buffer[50];

        if (end - start != 0)
        {
            buffer[0] = (char)code;
            buffer[1] = 0;

            SetValue("");
            this->AppendText(buffer);

            event.Skip(false);
        }
        else
        {
            std::strcpy(buffer, GetValue().c_str());
            uint length = std::strlen(buffer);
            buffer[length] = (char)code;
            if (length > SIZE_BUFFER - 2) { length = SIZE_BUFFER - 2; }
            buffer[length + 1] = 0;
            float value = (float)std::atof(buffer);

            event.Skip(value >= min && value <= max);
        }
    }
    else if (code == WXK_RETURN || code == WXK_BACK || code == WXK_LEFT || code == WXK_RIGHT || code == WXK_TAB || code == WXK_DELETE || code == WXK_INSERT)
    {
        event.Skip(true);
    }
    else
    {
        event.Skip(false);
    }

    dialog->SendAdditionForm();
}
