Sasha7b9Work/A101/sources/Device/src/Hardware/HAL/HAL_PINS.h

// (c) Aleksandr Shevchenko e-mail : Sasha7b9@tut.by
#pragma once


// Пины записи
#define PIN_US1     HPort::_C, HPin::_6
#define PIN_US2     HPort::_C, HPin::_7
#define PIN_US3     HPort::_C, HPin::_8
#define PIN_US4     HPort::_C, HPin::_9
#define PIN_US6     HPort::_D, HPin::_10
#define PIN_US7     HPort::_D, HPin::_11
#define PIN_US8     HPort::_D, HPin::_12
// Этот пин нужно переводить в единицу, перед переключением предела и возвращать в ноль после переключения.
// Особенность бесконтактного преобразователя тока на диапазонах 20А и 50А
#define PIN_ZERO    HPort::_B, HPin::_14
