Sasha7b9Work/A101/sources/Device/src/Nextion/Controls.h

// 2024/08/23 15:32:45 (c) Aleksandr Shevchenko e-mail : Sasha7b9@tut.by
#pragma once


struct Font
{
    enum E
    {
        _0_GB34b,
        _1_GB42b,
        _2_GB72b,
        _3_GB80_2,
        _4_GB80b,
        _5_GB30b,
        _6_GOST_B_128b,
        _7_GOST_B_144b,
        _8_GOST_B_160b,
        Count
    };
};
