Sasha7b9Work/A101/sources/Device/src/Nextion/Nextion.cpp

// 2022/10/17 15:30:27 (c) Aleksandr Shevchenko e-mail : Sasha7b9@tut.by
#include "defines.h"
#include "Nextion/Nextion.h"
#include "Hardware/HAL/HAL_PIO.h"
#include "Hardware/HAL/HAL.h"
#include "Menu/MenuItems.h"
#include "Hardware/Timer.h"
#include "Nextion/Keyboard.h"
#include "Ampermeter/Calibrator/Calibrator.h"
#include "Menu/Menu.h"
#include <cstdarg>
#include <cstdio>
#include <cstring>
#include <cstdlib>


#ifndef WIN32
#pragma clang diagnostic push
#pragma clang diagnostic ignored "-Wweak-vtables"
#endif


/*
*   Принимаем от дисплея
*  +------------+--------+--------+
*  | кнопка     | нажата | отжата |
*  +------------+--------+--------+
*  |      Page 0         |        |
*  |   1        |  "0Z"  |        |
*  |   2        |  "1Z"  |        |
*  |   3        |  "2Z"  |        |
*  |   4        |  "3Z"  |        |
*  |   5        |  "4Z"  |        |
*  |   6        |  "5Z"  |        |
*  |  Меню      |  "6Z"  |        |
*  |      Page 1 калибровка       |
*  | Пропустить |        |  "7Z"  |
*  | Готово     |        |  "8Z"  |
*  +------------+--------+--------+
* 
*   Передаём в дисплей
* 
*   1. Элементы дисплея
*       Графики:
*   - waveInput - график входного сигнала
*   - waveInputSmall - уменьшенный график входного сигнала
*   - waveFFT - график БПФ
*   - waveFFTsmall - уменьшенный график БПФ
*       Текст:
*   - avp0...avp5 - метки АВП, соотвествующие кнопкам 1...6
*   - labelAC, textAC - отображение переменного измерения
*   - labelACsmall, textACsmall - уменьшенное отображение переменного напряжения
*   - labelDC, textDC - отображение постоянного измерения
*   - labelDCsmall, textDCsmall - уменьшенное отображение постоянного измерения
*       Кнопки:
*   - button0...button5 - 6 кнопок внизу экрана
*   - btMenu - кнопка меню
* 
*   2. Команды
*   - "vis waveInput,1" - включить отображение waveInput
*   - "button1.val=1" - "подсветить" button1
*   - "textAC.text="21.3008 mA"" нанести надпись на textAC
*/


namespace Nextion
{
    struct BufferUART //-V730
    {
        void Push(char);
        bool Pop(char *);
    private:
        static const int SIZE = 128;
        char buffer[SIZE];
        int in_p = 0;               // Сюда будет записываться байт из UART (Push)
        int out_p = 0;              // Этот байт нужно забирать
        bool mutex_uart = false;    // Если true, то буфер занят прерыванием
    };

    // Это приходит от дисплея
    struct Command
    {
        Command() : size(0) {} //-V730
        Command(pchar bytes, int _size);
        virtual ~Command() {}

        bool IsEmpty() const { return (size == 0); }
        virtual bool Execute() { return false; }
    protected:
        static const int MAX_LEN = 32;
        char buffer[MAX_LEN];
        int size;
    };


    struct CommandCoordinate : public Command
    {
        CommandCoordinate(pchar _bytes, int _size) : Command(_bytes, _size) {}

        virtual bool Execute() override;
    };


    // Служебный ответ дисплея
    struct AnswerFF : public Command
    {
        AnswerFF(pchar _bytes, int _size) : Command(_bytes, _size) {}
        virtual ~AnswerFF() override {}

        virtual bool Execute() override;
    };


    struct BufferData
    {
        BufferData() : pointer(0) {} //-V730

        void Push(char byte);
        Command *ExtractCommand();
        int NumBytes() const { return pointer; }
        char operator[](int i) { return buffer[i]; }
    private:
        static const int SIZE = 128;
        char buffer[SIZE];
        int pointer;
        void RemoveFromStart(int num_bytes);
    };
}


namespace Nextion
{
    static BufferUART bufferUART;                   // Сюда складываем даныне из UART

    static BufferData data;                         // А здесь принятые данные
}


void Nextion::Update()
{
    char byte = 0;

    while (bufferUART.Pop(&byte))
    {
        data.Push(byte);
    }

    bool run = true;

    while (run)
    {
        Command *command = data.ExtractCommand();

        run = command->Execute();

        delete command;
    }

    exist_command = false;
}


void Nextion::CallbackOnReceive(char byte)
{
    bufferUART.Push(byte);

    if (byte == (uint8)'-' || byte == (uint8)'+')
    {
        exist_command = true;
    }
}


bool Nextion::ExixtCommnadsForExecute()
{
    return exist_command;
}


Nextion::Command::Command(const char *bytes, int _size) : size(_size)
{
    std::memcpy(buffer, bytes, (uint)size);
    buffer[size] = '\0';
}


bool Nextion::CommandCoordinate::Execute()
{
    BitSet32 x((uint *)buffer);
    BitSet32 y((uint *)(buffer + 4));

    if (buffer[8] == '+')
    {
        Keyboard::CallbackOnPress((int)x.word, (int)y.word);
    }
    else if (buffer[8] == '-')
    {
        Keyboard::CallbackOnRelease((int)x.word, (int)y.word);
    }

    return true;
}


bool Nextion::AnswerFF::Execute()
{
    if (IsEmpty())
    {
        return false;
    }

    return true;
}


void Nextion::BufferData::Push(char byte)
{
    if (pointer == SIZE)
    {
        RemoveFromStart(1);
    }

    buffer[pointer++] = byte;
}


Nextion::Command *Nextion::BufferData::ExtractCommand()
{
    for (int i = 0; i < pointer; i++)
    {
        if (buffer[i] == (uint8)'+' || buffer[i] == (uint8)'-')
        {
            int num_symbols = i + 1;

            if (i == 8)
            {
                CommandCoordinate *result = new CommandCoordinate(buffer, num_symbols);

                RemoveFromStart(num_symbols);

                return result;
            }
            else
            {
                RemoveFromStart(num_symbols);
            }
        }
    }

    if (pointer > 3)
    {
        for (int i = 0; i < pointer - 2; i++)
        {
            if (std::memcmp(&buffer[i], "\xFF\xFF\xFF", 3) == 0)
            {
                AnswerFF *result = new AnswerFF(buffer, i);

//                for (int j = 0; j < i + 3; j++)
//                {
//                    char symbol[2] = { (char)buffer[j], '\0' };
//                    HAL_USART3::SendText(symbol);
//                }

                RemoveFromStart(i + 3);

                return result;
            }
        }
    }

    return new Command();
}


void Nextion::BufferData::RemoveFromStart(int num_bytes)
{
    if (num_bytes == pointer)
    {
        pointer = 0;
    }
    else
    {
        std::memmove(buffer, buffer + num_bytes, (uint)(pointer - num_bytes));
        pointer -= num_bytes;
    }
}


void Nextion::BufferUART::Push(char byte)
{
    mutex_uart = true;

    if (out_p > 1)
    {
        int num_bytes = out_p;

        std::memmove(buffer, buffer + num_bytes, (size_t)num_bytes);

        out_p = 0;
        in_p -= num_bytes;
    }

    buffer[in_p++] = byte;

    mutex_uart = false;
}


bool Nextion::BufferUART::Pop(char *byte)
{
    if (mutex_uart || in_p == out_p)
    {
        return false;
    }

    *byte = buffer[out_p++];

    return true;
}


void Nextion::DrawLineH(int y, int x1, int x2, const Color &color)
{
    DrawLine(x1, y, x2, y, color);
}


void Nextion::DrawLineV(int x, int y1, int y2, const Color &color)
{
    DrawLine(x, y1, x, y2, color);
}


void Nextion::WaveInput::Draw(const Rect &rect, uint16 *points)
{
    Rect rect_fill = rect;
    rect_fill.x += 1;

    Nextion::FillRect(rect_fill, Color::Background);

    const int num_points = rect.width;
    const int x = rect.x;

    Nextion::DrawLineH(rect.y, rect.x, rect.x + rect.width, Color::Gray75);
    Nextion::DrawLineH(rect.y + rect.height / 2, rect.x, rect.x + rect.width);
    Nextion::DrawLineH(rect.y + rect.height, rect.x, rect.x + rect.width);

    for (int i = 0; i < num_points - 1; i++)
    {
        Nextion::DrawLineWhite(
            x + i,
            points[i],
            x + i + 1,
            points[i + 1]);
    }
}


#ifndef WIN32
#pragma clang diagnostic pop
#endif
