Sasha7b9Work/A101/sources/Device/src/Hardware/HAL/HAL.cpp

// (c) Aleksandr Shevchenko e-mail : Sasha7b9@tut.by
#include "defines.h"
#include "defines.cpp"
#include "Hardware/HAL/HAL.h"
#include "Hardware/HAL/HAL_PIO.h"
#include "Hardware/Timer.h"
#include "stm_includes.h"


namespace HAL
{
    static void SystemClockConfig();

    static void EnablePeriphery();

    // По этому адресу хранится версия сборки, чтобы прошивальщим мог её прочитать и сравнить с той, что зашита в новой прошивке
    static volatile const uint PROGRAM_VERSION_BUILD __attribute__((used)) __attribute__((section(".ARM.__at_0x08022000"))) = VERSION_BUILD;
    static volatile const char PROGRAM_DATE_BUILD[]  __attribute__((used)) __attribute__((section(".ARM.__at_0x08022004"))) = DATE_BUILD;
}


void HAL::Init()
{
    SystemClockConfig();

    EnablePeriphery();

    HAL_Init();

    HAL_PIO::Init();

    HAL_SPI2::Init();

    HAL_UART4::Init();

    HAL_USART2::Init();

    HAL_USART3::Init();

    HAL_TIM2::Init();

    HAL_TIM3::Init();

    Timer::Init();
}


void HAL::SystemClockConfig()
{
    RCC_OscInitTypeDef RCC_OscInitStruct;
    RCC_ClkInitTypeDef RCC_ClkInitStruct;

    __HAL_RCC_PWR_CLK_ENABLE();

    __HAL_PWR_VOLTAGESCALING_CONFIG(PWR_REGULATOR_VOLTAGE_SCALE1);
    RCC_OscInitStruct.OscillatorType = RCC_OSCILLATORTYPE_HSE;
    RCC_OscInitStruct.HSEState = RCC_HSE_ON;
    RCC_OscInitStruct.PLL.PLLState = RCC_PLL_ON;
    RCC_OscInitStruct.PLL.PLLSource = RCC_PLLSOURCE_HSE;
    RCC_OscInitStruct.PLL.PLLM = 4;
    RCC_OscInitStruct.PLL.PLLN = 168;
    RCC_OscInitStruct.PLL.PLLP = RCC_PLLP_DIV2;
    RCC_OscInitStruct.PLL.PLLQ = 4;

    if(HAL_RCC_OscConfig(&RCC_OscInitStruct) != HAL_OK)
    {
        ERROR_HANDLER();
    }

    RCC_ClkInitStruct.ClockType = RCC_CLOCKTYPE_HCLK | RCC_CLOCKTYPE_SYSCLK
        | RCC_CLOCKTYPE_PCLK1 | RCC_CLOCKTYPE_PCLK2;
    RCC_ClkInitStruct.SYSCLKSource = RCC_SYSCLKSOURCE_PLLCLK;
    RCC_ClkInitStruct.AHBCLKDivider = RCC_SYSCLK_DIV1;
    RCC_ClkInitStruct.APB1CLKDivider = RCC_HCLK_DIV4;
    RCC_ClkInitStruct.APB2CLKDivider = RCC_HCLK_DIV2;

    if(HAL_RCC_ClockConfig(&RCC_ClkInitStruct, FLASH_LATENCY_5) != HAL_OK)
    {
        ERROR_HANDLER();
    }

    /**Configure the Systick interrupt time
    */
    HAL_SYSTICK_Config(HAL_RCC_GetHCLKFreq() / 1000);

    /**Configure the Systick
    */
    HAL_SYSTICK_CLKSourceConfig(SYSTICK_CLKSOURCE_HCLK);

    /* SysTick_IRQn interrupt configuration */
    HAL_NVIC_SetPriority(SysTick_IRQn, 0, 0);
}


void HAL::EnablePeriphery()
{
    __HAL_RCC_GPIOA_CLK_ENABLE();
    __HAL_RCC_GPIOB_CLK_ENABLE();
    __HAL_RCC_GPIOC_CLK_ENABLE();
    __HAL_RCC_GPIOD_CLK_ENABLE();
    __HAL_RCC_GPIOE_CLK_ENABLE();
    __HAL_RCC_GPIOF_CLK_ENABLE();
    __HAL_RCC_GPIOG_CLK_ENABLE();
    __HAL_RCC_GPIOH_CLK_ENABLE();

    __HAL_RCC_FSMC_CLK_ENABLE();
    __HAL_RCC_I2C1_CLK_ENABLE();
    __HAL_RCC_SPI1_CLK_ENABLE();
    __HAL_RCC_SPI3_CLK_ENABLE();    // AD9952
}


void HAL_MspInit()
{
    HAL_NVIC_SetPriorityGrouping(NVIC_PRIORITYGROUP_4);

    /* System interrupt init*/
    /* MemoryManagement_IRQn interrupt configuration */
    HAL_NVIC_SetPriority(MemoryManagement_IRQn, 0, 0);
    /* BusFault_IRQn interrupt configuration */
    HAL_NVIC_SetPriority(BusFault_IRQn, 0, 0);
    /* UsageFault_IRQn interrupt configuration */
    HAL_NVIC_SetPriority(UsageFault_IRQn, 0, 0);
    /* SVCall_IRQn interrupt configuration */
    HAL_NVIC_SetPriority(SVCall_IRQn, 0, 0);
    /* DebugMonitor_IRQn interrupt configuration */
    HAL_NVIC_SetPriority(DebugMonitor_IRQn, 0, 0);
    /* PendSV_IRQn interrupt configuration */
    HAL_NVIC_SetPriority(PendSV_IRQn, 0, 0);
    /* SysTick_IRQn interrupt configuration */
    HAL_NVIC_SetPriority(SysTick_IRQn, 0, 0);
}


void assert_failed(uint8_t *, uint32_t)
{
}


void HAL::ErrorHandler()
{
}
