Sasha7b9Work/A101/sources/Device/src/Nextion/Nextion.h

// 2022/10/17 15:30:21 (c) Aleksandr Shevchenko e-mail : Sasha7b9@tut.by
#pragma once
#include "Nextion/Colors.h"
#include "Utils/Math.h"


// Код ответа дисплея
struct ResponseCode
{
    enum E
    {
        InvalidInstruction             = 0x00,
        InstructionSuccessful          = 0x01,
        InvalidComponentID             = 0x02,
        InvalidPageID                  = 0x03,
        InvalidPictureID               = 0x04,
        InvalidFontID                  = 0x05,
        InvalidFileOperation           = 0x06,
        InvalidCRC                     = 0x09,
        InvalidBaudRate                = 0x11,
        InvalidWaveformIDorChannel     = 0x12,
        InvalidVariableNameOrAttribute = 0x1A,
        InvalidVariableOperation       = 0x1B,
        AssignmentFailedToAssign       = 0x1C,
        EEPROMoperationFailed          = 0x1D,
        InvalidQuantityOfParameters    = 0x1E,
        IOoperationFailed              = 0x1F,
        EscapeCharacterInvalid         = 0x20,
        VariableNameTooLong            = 0x23,
        SerialBufferOverflow           = 0x24,
        NextionReady                   = 0x88,
        StartMicroSDupgrade            = 0x89,
        TransparentDataFinished        = 0xFD,
        TransparentDataReady           = 0xFE,
        None                           = 0xFF
    };
};


namespace Nextion
{
    // Функция вызывается в главном цикле
    void Update();

    bool ExixtCommnadsForExecute();

    // Эта функция вызвается по приходу байта с дисплея
    void CallbackOnReceive(char);

    void DrawRect(const Rect &, const Color & = Color::Count);

    void FillRect(const Rect &, const Color & = Color::Count);

    void DrawLine(int x1, int y1, int x2, int y2, const Color & = Color::Count);
    void DrawLineWhite(int x1, int y1, int x2, int y2);

    void DrawLineH(int y, int x1, int x2, const Color & = Color::Count);

    void DrawLineV(int x, int y1, int y2, const Color & = Color::Count);

    // h_align - горизонтальное выравнивание. 0 - лево, 1 - центр
    void DrawString(const Rect &, int font, const Color &color, const Color &back_color, pchar, bool h_align = false, bool v_align = false);

    void DrawSpaceForStar();

    void DrawStarForStar();

    void SendCommandFormat(const char *, ...);

    static bool exist_command = false;      // Если true - есть команды для исполнения

    namespace Page
    {
        // 0 - основная страница
        // 1 - страница калибровки
        void Enable(int number);
    }

    namespace WaveInput
    {
        void Draw(const Rect &, uint16 *points);

        // 0 - маленький, 1 - большой
        void Enable(int size);

        // 0 - маленький, 1 - большой
        void Disable(int size);
    }

    namespace WaveFFT
    {
        // 0 - маленький, 1 - большой
        void Enable(int size);

        // 0 - маленький, 1 - большой
        void Disable(int size);
    }
}
