Sasha7b9Work/A101/sources/VS/Explorer/src/Dialogs/ExponentDialog.cpp

// (c) Aleksandr Shevchenko e-mail : Sasha7b9@tut.by
#include "defines.h"
#include "Controls/SpinControl.h"
#include "Dialogs/ExponentDialog.h"
#include "Editor/Form.h"
#include "Utils/Utils.h"

#pragma warning(push, 0)
#include <wx/spinctrl.h>
#include <wx/statline.h>
#pragma warning(pop)


static int power = 2000;
static bool type1 = true;
static bool type2 = false;
static bool type3 = false;
static bool type4 = false;


wxPanel *ExponentDialog::CreatePanelPower()
{
    wxPanel *panel = new wxPanel(this);

    new wxStaticBox(panel, wxID_ANY, wxT("Постоянная времени"), wxDefaultPosition, { 130, 75 });

    scPower = new SpinControl(panel, wxID_ANY, { 20, 20 }, { 100, 20 }, 0, std::numeric_limits<int>::max(), power,
                              this, wxCommandEventHandler(ExponentDialog::OnControlEvent), wxT(""), this);
    return panel;
}


wxPanel *ExponentDialog::CreatePanelType()
{
    wxPanel *panel = new wxPanel(this);
    new wxStaticBox(panel, wxID_ANY, wxT("Вид"), wxDefaultPosition, wxSize(90, 75));

    int y = 25, x = 10, dY = 25, dX = 45;

    rbType1 = new wxRadioButton(panel, wxID_ANY, wxT("1"), { x, y });
    Connect(rbType1->GetId(), wxEVT_RADIOBUTTON, wxCommandEventHandler(Dialog::OnControlEvent));

    rbType2 = new wxRadioButton(panel, wxID_ANY, wxT("2"), { x, y + dY });
    Connect(rbType2->GetId(), wxEVT_RADIOBUTTON, wxCommandEventHandler(Dialog::OnControlEvent));

    rbType3 = new wxRadioButton(panel, wxID_ANY, wxT("3"), { x + dX, y });
    Connect(rbType3->GetId(), wxEVT_RADIOBUTTON, wxCommandEventHandler(Dialog::OnControlEvent));

    rbType4 = new wxRadioButton(panel, wxID_ANY, wxT("4"), { x + dX, y + dY });
    Connect(rbType4->GetId(), wxEVT_RADIOBUTTON, wxCommandEventHandler(Dialog::OnControlEvent));
  
    rbType1->SetValue(type1);
    rbType2->SetValue(type2);
    rbType3->SetValue(type3);
    rbType4->SetValue(type4);

    return panel;
}


ExponentDialog::ExponentDialog() : Dialog(wxT("Параметры экспоненциального сигнала"), true)
{
    wxBoxSizer *vBox = new wxBoxSizer(wxVERTICAL);
    wxBoxSizer *hBoxPanels = new wxBoxSizer(wxHORIZONTAL);

    hBoxPanels->Add(CreatePanelType());
    hBoxPanels->AddStretchSpacer();
    hBoxPanels->Add(CreatePanelPower());
    vBox->Add(hBoxPanels);

    Dialog::SetBoxSizer(vBox, { 221, 80 });
}


void ExponentDialog::InvertPoint(uint16 *point)
{
    *point = (uint16)((uint16)(Point::MAX - *point) + Point::AVE);
}


void ExponentDialog::ShiftToUp()
{
    uint16 max = 0;

    for (int i = 0; i < Point::AMOUNT; i++)
    {
        if (data[i] > max)
        {
            max = data[i];
        }
    }

    if (max != 4095)
    {
        uint16 delta = 4095U - max;

        for (int i = 0; i < Point::AMOUNT; i++)
        {
            data[i] += delta;
        }
    }
}


void ExponentDialog::SendAdditionForm()
{
    double tau = Math::LimitationBelow<double>(scPower->GetValue() + 1.0, 2.0);

    double x0 = Point::AMOUNT - 1;
    double y0 = Point::AVE;

    double x1 = x0 - 1.0;
    double y1 = y0 * (1.0 - 1.0 / tau);

    double k = (std::log(y0) - std::log(y1)) / (x0 - x1);

    int start = (int)(std::log(y0) / k - x0);

    for (int i = 0; i < Point::AMOUNT; i++)
    {
        double value = std::exp(k * ((double)i + start));

        uint16 uValue = (uint16)(Point::AVE + value);

        data[i] = Math::Limitation<uint16>(uValue, Point::MIN, Point::MAX);
    }

    if (rbType2->GetValue())
    {
        for (int i = 0; i < Point::AMOUNT / 2; i++)
        {
            Math::Swap<uint16>(&data[i], &data[Point::AMOUNT - 1 - i]);
        }
    }
    else if (rbType3->GetValue())
    {
        for (int i = 0; i < Point::AMOUNT; i++)
        {
            InvertPoint(&data[i]);
        }
    }
    else if (rbType4->GetValue())
    {
        for (int i = 0; i < Point::AMOUNT / 2; i++)
        {
            Math::Swap<uint16>(&data[i], &data[Point::AMOUNT - 1 - i]);
            InvertPoint(&data[i]);
            InvertPoint(&data[Point::AMOUNT - 1 - i]);
        }
    }

    ShiftToUp();

    TheForm->SetAdditionForm(data);

    points.clear();
}


void ExponentDialog::SaveValues()
{
    power = scPower->GetValue();

    type1 = rbType1->GetValue();
    type2 = rbType2->GetValue();
    type3 = rbType3->GetValue();
    type4 = rbType4->GetValue();
}
