Sasha7b9Work/A101/sources/VS/Explorer/src/Dialogs/ParametersDialog.cpp

// (c) Aleksandr Shevchenko e-mail : Sasha7b9@tut.by
#include "defines.h"
#include "Controls/SpinControl.h"
#include "Controls/TextControl.h"
#include "Dialogs/ParametersDialog.h"
#include "Editor/Form.h"


#define SMALL_BUTTON_SIZE wxSize(70, 20)

#define ADD_SPACER(hwd) hwd->AddSpacer(20);


ParametersDialog::ParametersDialog(uint16 index, uint16 value) : wxDialog(nullptr, wxID_ANY, wxT("Параметры точки"))
{
    wxPoint pos(50, 0);
    wxSize  size(50, 20);
    char buffer[100];

    //////////////////////////////////////////////////////////////////////////////////////////////////////////////////////////

    wxStaticText *stPosition = new wxStaticText(this, wxID_ANY, wxT("Индекс"));
    tcPosition = new TextControlInt(0, 8 * 1024 - 1, this, wxID_ANY, _itoa(index, buffer, 10), pos, size);

    wxBoxSizer *hBoxPosition = new wxBoxSizer(wxHORIZONTAL);

    ADD_SPACER(hBoxPosition);
    hBoxPosition->Add(stPosition, 1, wxALIGN_CENTER);
    ADD_SPACER(hBoxPosition);
    hBoxPosition->Add(tcPosition, 1, wxALIGN_CENTER);
    ADD_SPACER(hBoxPosition);

    //////////////////////////////////////////////////////////////////////////////////////////////////////////////////////////

    wxStaticText *stValue = new wxStaticText(this, wxID_ANY, wxT("Значение"));
    tcValue = new TextControlInt(0, 4095, this, wxID_ANY, _itoa(value, buffer, 10), pos, size);

    wxBoxSizer *hBoxValue = new wxBoxSizer(wxHORIZONTAL);

    ADD_SPACER(hBoxValue);
    hBoxValue->Add(stValue, 1, wxALIGN_CENTER);
    ADD_SPACER(hBoxValue);
    hBoxValue->Add(tcValue, 1, wxALIGN_CENTER);
    ADD_SPACER(hBoxValue);

    //////////////////////////////////////////////////////////////////////////////////////////////////////////////////////////

    wxButton *btnOk = new wxButton(this, wxID_ANY, wxT("Применить"), wxDefaultPosition, SMALL_BUTTON_SIZE);
    Connect(btnOk->GetId(), wxEVT_BUTTON, wxCommandEventHandler(ParametersDialog::OnButtonApply));

    wxButton *btnClose = new wxButton(this, wxID_ANY, wxT("Закрыть"), wxDefaultPosition, SMALL_BUTTON_SIZE);
    Connect(btnClose->GetId(), wxEVT_BUTTON, wxCommandEventHandler(ParametersDialog::OnButtonClose));

    wxBoxSizer *hBoxButtons = new wxBoxSizer(wxHORIZONTAL);

    hBoxButtons->Add(btnOk, 1, wxALIGN_CENTER);
    hBoxButtons->AddSpacer(20);
    hBoxButtons->Add(btnClose, 1, wxALIGN_CENTER);

    //////////////////////////////////////////////////////////////////////////////////////////////////////////////////////////

    wxBoxSizer *vBox = new wxBoxSizer(wxVERTICAL);          // Главный бокс

    vBox->AddSpacer(10);
    vBox->Add(hBoxPosition, 0, wxALIGN_CENTER);
    vBox->AddSpacer(10);
    vBox->Add(hBoxValue, 0, wxALIGN_CENTER);
    vBox->AddSpacer(10);
    vBox->Add(hBoxButtons, 0, wxALIGN_CENTER);

    SetSizer(vBox);

    wxWindowBase::SetClientSize({ 170, 100 });

    Centre();

    SetFocus(); //-V1053
}


void ParametersDialog::OnButtonApply(wxCommandEvent &)
{
    uint16 index = (uint16)atoi(tcPosition->GetValue().c_str());
    uint16 value = (uint16)atoi(tcValue->GetValue().c_str());

    TheForm->RemoveCurrentMarker();
    TheForm->SetPointInRealCoord(index, value);

    Destroy();
}


void ParametersDialog::OnButtonClose(wxCommandEvent &)
{
    Destroy();
}
