Sasha7b9Work/A101/sources/Device/src/Hardware/HAL/HAL_PIO.cpp

// (c) Aleksandr Shevchenko e-mail : Sasha7b9@tut.by
#include "defines.h"
#include "Hardware/HAL/HAL_PIO.h"
#include "stm_includes.h"


const uint16 HPin::_0 = GPIO_PIN_0;
const uint16 HPin::_1 = GPIO_PIN_1;
const uint16 HPin::_2 = GPIO_PIN_2;
const uint16 HPin::_3 = GPIO_PIN_3;
const uint16 HPin::_4 = GPIO_PIN_4;
const uint16 HPin::_5 = GPIO_PIN_5;
const uint16 HPin::_6 = GPIO_PIN_6;
const uint16 HPin::_7 = GPIO_PIN_7;
const uint16 HPin::_8 = GPIO_PIN_8;
const uint16 HPin::_9 = GPIO_PIN_9;
const uint16 HPin::_10 = GPIO_PIN_10;
const uint16 HPin::_11 = GPIO_PIN_11;
const uint16 HPin::_12 = GPIO_PIN_12;
const uint16 HPin::_13 = GPIO_PIN_13;
const uint16 HPin::_14 = GPIO_PIN_14;
const uint16 HPin::_15 = GPIO_PIN_15;


static const uint modes[HMode::Count] =
{
    GPIO_MODE_AF_PP,
    GPIO_MODE_OUTPUT_PP
};

static const uint pulles[HPull::Count] =
{
    GPIO_NOPULL,
    GPIO_PULLDOWN,
    GPIO_PULLUP
};

static const uint speedes[HSpeed::Count] =
{
    GPIO_SPEED_FREQ_LOW,
    GPIO_SPEED_FREQ_HIGH
};

static const uint alternates[HAlternate::Count] =
{
    GPIO_AF7_USART2,
    GPIO_AF7_USART3,
    GPIO_AF8_UART4
};


static GPIO_TypeDef * const ports[HPort::Count] =
{
    GPIOA,
    GPIOB,
    GPIOC,
    GPIOD,
    GPIOE,
    GPIOF,
    GPIOG,
    GPIOH
};

#define PORT(p)      (ports[p])
#define MODE(m)      (modes[m])
#define PULL(p)      (pulles[p])
#define SPEED(s)     (speedes[s])
#define ALTERNATE(a) (alternates[a])



void HAL_PIO::Init(HPort::E port, uint pins, HMode::E mode, HPull::E pull, HSpeed::E speed, HAlternate::E alternate)
{
    GPIO_InitTypeDef isGPIO =
    {
        pins,
        MODE(mode),
        PULL(pull),
        SPEED(speed),
        ALTERNATE(alternate)
    };

    HAL_GPIO_Init(PORT(port), &isGPIO);
}


void HAL_PIO::Set(HPort::E port, uint16 pin)
{
    HAL_GPIO_WritePin(PORT(port), pin, GPIO_PIN_SET);
}


void HAL_PIO::Set(const StructPIN &pin)
{
    HAL_GPIO_WritePin(PORT(pin.port), pin.pin, GPIO_PIN_SET);
}


void HAL_PIO::Reset(HPort::E port, uint16 pin)
{
    HAL_GPIO_WritePin(PORT(port), pin, GPIO_PIN_RESET);
}


void HAL_PIO::Reset(const StructPIN &pin)
{
    HAL_GPIO_WritePin(PORT(pin.port), pin.pin, GPIO_PIN_RESET);
}


void HAL_PIO::Write(HPort::E port, uint16 pin, HState::E state)
{
    HAL_GPIO_WritePin(PORT(port), pin, (state == HState::Set) ? GPIO_PIN_SET : GPIO_PIN_RESET);
}


void HAL_PIO::Write(HPort::E port, uint16 pin, bool state)
{
#ifdef OLD_VERSION

    if (pin == HPin::_14 && port == HPort::_B)
    {
        state = !state;
    }

#endif

    HAL_GPIO_WritePin(PORT(port), pin, state ? GPIO_PIN_SET : GPIO_PIN_RESET);
}


uint8 HAL_PIO::Read(HPort::E port, uint16 pin)
{
    return (uint8)HAL_GPIO_ReadPin(PORT(port), pin);
}


void HAL_PIO::Init()
{
    __HAL_RCC_GPIOA_CLK_ENABLE();
    __HAL_RCC_GPIOB_CLK_ENABLE();
    __HAL_RCC_GPIOC_CLK_ENABLE();
    __HAL_RCC_GPIOD_CLK_ENABLE();
    __HAL_RCC_GPIOE_CLK_ENABLE();
    __HAL_RCC_GPIOF_CLK_ENABLE();
    __HAL_RCC_GPIOG_CLK_ENABLE();
    __HAL_RCC_GPIOH_CLK_ENABLE();

    StructPIN writePins[] =
    {
        {PIN_US1},
        {PIN_US2},
        {PIN_US3},
        {PIN_US4},
        {PIN_US6},
        {PIN_US7},
        {PIN_US8},
        {PIN_ZERO},
        {HPort::Count, 0}
    };

    StructPIN *str = writePins;

    while(str->port != HPort::Count)
    {
        Init(str->port, str->pin, HMode::Output_PP, HPull::No, HSpeed::High);
        Reset(str->port, str->pin);

        str++;
    }

    HAL_PIO::Write(PIN_ZERO, true);
}
