Sasha7b9Work/A101/sources/Device/src/Nextion/Nextion_stm.cpp

// 2022/10/31 19:37:02 (c) Aleksandr Shevchenko e-mail : Sasha7b9@tut.by
#include "defines.h"
#include "Nextion/Nextion.h"
#include "Nextion/DiagramInput.h"
#include "Hardware/Timer.h"
#include "Hardware/HAL/HAL.h"
#include "Nextion/Display.h"
#include <cstdarg>
#include <cstdio>
#include <cstring>


namespace Nextion
{
    static void SendCommandRAW(pchar);

    static pchar Convert(pchar text)
    {
        static uint8 buffer[32];

        uint8 *pointer = buffer;

        while (*text)
        {
            *pointer = (uint8)*text;

            if (*pointer > 127)
            {
                *pointer = (uint8)((*pointer) - 16);
            }

            text++;
            pointer++;
        }

        *pointer = 0;

        return (pchar)buffer;
    }
}


void Nextion::DrawRect(const Rect &rect, const Color &color)
{
    color.SetAsCurrent();

    SendCommandFormat("draw %d,%d,%d,%d,%s", rect.x, rect.y, rect.x + rect.width, rect.y + rect.height, Color::Current().ValueString());
}


void Nextion::FillRect(const Rect &rect, const Color & color)
{
    color.SetAsCurrent();

    SendCommandFormat("fill %d,%d,%d,%d,%s", rect.x, rect.y, rect.width, rect.height, Color::Current().ValueString());
}


void Nextion::DrawLine(int x1, int y1, int x2, int y2, const Color &color)
{
    color.SetAsCurrent();

    SendCommandFormat("line %d,%d,%d,%d,%s", x1, y1, x2, y2, Color::Current().ValueString());
}


void Nextion::DrawLineWhite(int x1, int y1, int x2, int y2)
{
    char buffer[128];

    sprintf(buffer, "line %d,%d,%d,%d,65535", x1, y1, x2, y2);

    SendCommandRAW(buffer);
}


void Nextion::SendCommandFormat(const char *format, ...)
{
    char message[256];

    std::va_list args;
    va_start(args, format);
    std::vsprintf(message, format, args);
    va_end(args);

    SendCommandRAW(message);
}


void Nextion::SendCommandRAW(pchar command)
{
    HAL_USART2::SendNZ(command);

    HAL_USART2::SendNZ("\xFF\xFF\xFF");
}


void Nextion::DrawString(const Rect &rect, int font, const Color &color, const Color &back_color, pchar text, bool h_align, bool v_align)
{
    SendCommandFormat("xstr %d,%d,%d,%d,%d,%s,%s,%d,%d,1,\"%s\"",
        rect.x, rect.y, rect.width, rect.height, font, color.ValueString(), back_color.ValueString(), h_align ? 1 : 0, v_align ? 1 : 0, Convert(text));
}


void Nextion::DrawSpaceForStar()
{
    static const pchar message = "xstr 627,0,40,40,2,65535,6964,1,1,1,\" \"\xFF\xFF\xFF";

    HAL_USART2::TransmitIT(message);
}


void Nextion::DrawStarForStar()
{
    static const pchar message = "xstr 627,0,40,40,2,65535,6964,1,1,1,\"*\"\xFF\xFF\xFF";

    HAL_USART2::TransmitIT(message);
}


void Nextion::WaveInput::Enable(int size)
{
    SendCommandFormat("vis %s,1", size ? "waveBig" : "waveLeft");
}

void Nextion::WaveInput::Disable(int size)
{
    SendCommandFormat("vis %s,0", size ? "waveBig" : "waveLeft");
}


void Nextion::WaveFFT::Enable(int size)
{
    Nextion::SendCommandFormat("vis %s,1", size ? "waveBig" : "waveRight");
}


void Nextion::WaveFFT::Disable(int size)
{
    Nextion::SendCommandFormat("vis %s,0", size ? "waveBig" : "waveRight");
}


void Nextion::Page::Enable(int number)
{
    SendCommandFormat("page %d", number);
}
