Sasha7b9Work/A101/sources/Device/src/Hardware/HAL/HAL_USART2.cpp

// 2022/10/17 12:30:56 (c) Aleksandr Shevchenko e-mail : Sasha7b9@tut.by
#include "defines.h"
#include "Hardware/HAL/HAL.h"
#include "Hardware/HAL/HAL_PIO.h"
#include "Nextion/Nextion.h"
#include "stm_includes.h"
#include "Hardware/Timer.h"
#include <cstring>


namespace HAL_USART2
{
    static UART_HandleTypeDef handleUSART2 =
    {
        // 256000 - идут ошибки 0xFC
        // 250000 - ошибки
        // 230400 - работает, время 50-100 мс
        // 115200 - время 75-100 мс
        // 57600 - время 150-200 мс
        USART2,
        {
            115200,
            UART_WORDLENGTH_8B,
            UART_STOPBITS_1,
            UART_PARITY_NONE,
            UART_MODE_TX_RX,
            UART_HWCONTROL_NONE,
            UART_OVERSAMPLING_16
        },
        nullptr,
        0,
        0,
        nullptr,
        0,
        0,
        0,
        nullptr,
        nullptr,
        HAL_UNLOCKED,
        HAL_UART_STATE_RESET,
        HAL_UART_STATE_RESET,
        0
    };

    void *handle = (void *)&handleUSART2;

    static char buffer = 0;

    static bool transfer_IT_allowed = true;
}


void HAL_USART2::Init()
{
    __HAL_RCC_USART2_CLK_ENABLE();

    HAL_PIO::Init(HPort::_A, HPin::_2, HMode::AF_PP, HPull::No, HSpeed::High, HAlternate::AF7_USART2);      // TX
    HAL_PIO::Init(HPort::_A, HPin::_3, HMode::AF_PP, HPull::No, HSpeed::High, HAlternate::AF7_USART2);      // RX

    HAL_NVIC_SetPriority(USART2_IRQn, 0, 1);
    HAL_NVIC_EnableIRQ(USART2_IRQn);

    HAL_UART_Init(&handleUSART2);

    HAL_UART_Receive_IT(&handleUSART2, (uint8_t *)&buffer, 1);
}


void HAL_USART2::SendNZ(pchar command)
{
    while (!HAL_USART2::TransferITAllowed())
    {
    }

    HAL_UART_Transmit(&handleUSART2, (const uint8 *)command, (uint16)std::strlen(command), 100);
}


void HAL_USART2::CallbackOnReceive()
{
    Nextion::CallbackOnReceive(buffer);

    HAL_UART_Receive_IT(&handleUSART2, (uint8_t *)&buffer, 1);
}


bool HAL_USART2::TransferITAllowed()
{
    return transfer_IT_allowed;
}


void HAL_USART2::CallbackOnTransferIT()
{
    transfer_IT_allowed = true;
}


void HAL_USART2::TransmitIT(pchar data)
{
    transfer_IT_allowed = false;

    HAL_UART_Transmit_IT(&handleUSART2, (uint8_t *)data, (uint16)std::strlen(data));
}
