Sasha7b9Work/A101/sources/Loader/src/stm_includes.h

// 2022/10/27 08:02:41 (c) Aleksandr Shevchenko e-mail : Sasha7b9@tut.by
#pragma once

#ifndef WIN32
#pragma clang diagnostic push
#pragma clang diagnostic ignored "-Wc++98-compat-pedantic"
#pragma clang diagnostic ignored "-Wpadded"
#endif
#include <stm32f4xx_hal.h>
#ifndef WIN32
#pragma clang diagnostic pop
#endif
