Sasha7b9Work/A101/sources/Device/src/Measurer/Calculator.h

// 2022/10/19 08:16:06 (c) Aleksandr Shevchenko e-mail : Sasha7b9@tut.by
#pragma once
#include "Measurer/BufferADC.h"


namespace Calculator
{
    void AppendData(const BufferADC &);

    void SetAverages(int num_ave);

    float GetAC();

    float GetDC();
}
