Sasha7b9Work/A101/sources/Device/src/Utils/StringUtils.h

// 2025/11/13 08:46:26 (c) Aleksandr Shevchenko e-mail : Sasha7b9@tut.by
#pragma once


// Просто место для хранения строки
struct ParseBuffer
{
    char data[256];

    int GetLength() const;

    // true, строка соотвествует
    bool IsEqual(pchar) const;

    // Возвращает true, если здесь хранится параметр (две строки, разделённые символом '=')
    bool IsParameter(pchar param) const;
};


namespace SU
{
    // Нумерация начинается с 1
    char *GetWord(pchar data, int num, ParseBuffer *);

    // Нумерация начинается с 1
    char *GetString(pchar data, int num, char *out, pchar *first_symbol = nullptr);

    // Считывает значение int из десятичного ASCII-представления
    bool AtoIntDec(pchar, int *value);

    // Считывает значение uint из десятичного или шестнадцатиричного ASCII-представления
    bool AtoUInt(pchar, uint *value, int radix);

    uint CalculateCRC32(const void *buffer, int size);
}
