Sasha7b9Work/A101/sources/VS/A101-GUI/Hardware/HAL/HAL_USART2_win.cpp

// 2022/10/21 17:02:19 (c) Aleksandr Shevchenko e-mail : Sasha7b9@tut.by
#include "defines.h"
#include "Hardware/HAL/HAL.h"


void HAL_USART2::SendNZ(pchar)
{

}


bool HAL_USART2::TransferITAllowed()
{
    return true;
}


void HAL_USART2::TransmitIT(pchar)
{

}
