Sasha7b9Work/A101/(commit log)

2022-10-13 схемы
2022-10-17 Добавлены файлы от G6-49
2022-10-17 Обновленая CubeMX
2022-10-17 Скомпиилровалась первая версия
2022-10-17 Работает
2022-10-17 компилируется vs_keil
2022-10-17 НАстроены внутренние частоты на кварц 8МГц
2022-10-17 Идёт приём от дисплея
2022-10-17 По идее должны щёлкать реле, но щёлкает только один раз после первого нажатия
2022-10-17 Пофикшено. Что-то переключается
2022-10-21 добавлены скрипты для ThirdParty
2022-10-26 Переход на 6-ю версия компилятора keil
2022-10-26 показания в release нормальные
2022-10-27 Вроде перестали сбоить измерения
2022-10-28 Не работает
2022-10-28 Криво зажглись надписи
2022-10-28 Будем переходить на ручную отрисовку Text
2022-10-28 Перестало зависать - не хватало стека
2022-10-28 Последняя версия wxWidgets с github
2022-10-28 Заготовка GUI-version собирается и запускается
2022-10-29 Не работает отрисовка
2022-10-29 Преобразование цвета работает корректно
2022-10-29 В прошивке дисплея кнопки заменены на обычные
2022-10-29 Не работает новый интерфейс
2022-10-29 Работает новый интерфейс
2022-10-29 Добавлены заготовки для страниц калибровки и отладки
2022-10-29 заготовка для включения/отключения графиков
2022-10-30 добавлена заготовка для Updater
2022-10-31 Работает интерфейс, только кнопки не фиксируются
2022-10-31 Не работает новый алгоритм приёма с UART
2022-10-31 Работают кнопки как надо
2022-10-31 На скорости 115200 всё работает как надо
2022-11-01 Неправильно считает
2022-11-01 Правильно считает
2022-11-01 По идее, должен работать встроенный генератор
2022-11-01 Добавлены файлы DSP
2022-11-01 Переход на Keil 5.37
2022-11-01 неправильно определяет главную частоту спектра
2022-11-01 правильно рассчитывает главную частоту спектра
2022-11-02 Заготовка для панели управления
2022-11-02 Компилируется Control Panel
2022-11-02 Сделано окошко ввода номера ком-порта
2022-11-02 Не читает ком-порт
2022-11-02 Читает ком-порт
2022-11-02 буфер для приёма данных scpi
2022-11-03 Теперь правильно считывается значение АЦП
2022-11-06 Теперь кнопка Меню скрыта при запуске
2022-11-06 Исправлен расчёт периода
2022-11-08 Подготовка к преобразованию в амперы
2022-11-08 Вроде преобразует в амперы
2022-11-08 Скорректирован вывод измерений в плане количества выводимых перед запятой символов
2022-11-09 работает в отладочном режиме
2022-11-09 работает в release
2022-11-09 считает интеграл, но очень медленно
2022-11-09 Подлкючён CCM
2022-11-09 Восстановлена работоспособность release-версии
2022-11-09 8192 точки
2022-11-09 Добавлены файлы для эксплорера
2022-11-10 Добит вроде расчёт периода
2022-11-10 Считает АС, но с большой погрешностью
2022-11-10 !!!!!!!!!!!!!!!!!!!!!!!!!!!!!!!!!!!!!!!!!! Вроде бы нормально измеряет
2022-11-10 Похоже, работает черновой поиск DC
2022-11-10 работает поиск DC
2022-11-10 Похоже на окончательный вариант по точкам и частоте дискретизации
2022-11-10 Данные АЦП перенесены в CCM
2022-11-10 Теперь фон на надписях другого цвета
2022-11-11 точка в дисплее
2022-11-12 Добавлены файлы от примера FIR
2022-11-12 Компилируется пример FIR
2022-11-12 компилируется fir
2022-11-12 При переходе на хранение данных АЦП в float перестало работать
2022-11-12 Возвращено к хранению данных АЦП в INT
2022-11-14 Не зависает, хоть и не показывает цифры
2022-11-14 Работает дешифратор пароля
2022-11-14 Включается страница калибровки по паролю
2022-11-15 Первый вариант FIR
2022-11-15 Вроде фильтрует
2022-11-15 Есть эффект от фильтра
2022-11-15 Не компилируется - не хватает памяти
2022-11-15 Подключен генератор
2022-11-15 Меандр с генератора
2022-11-16 Пофикшено залипание кнопок
2022-11-16 ПОпытка сделать страницу калибровки
2022-11-16 Неудачно реализован выход за границы диапазона
2022-11-17 Цвет фона
2022-11-17 Не компилируется nextion (памяти не хватает)
2022-11-18 В исходной кодировке
2022-11-21 Отрабатывает ГИП калибровки
2022-11-21 Работает timeline в калибровке
2022-11-21 Подогнаны нули в очередной раз
2022-11-21 начинаем калибровать ноль
2022-11-21 Калибрует ноль, но ооооочень медленно
2022-11-21 Попытка вывода калибровочных данных
2022-11-21 Можно сказать, ноль калибруется
2022-11-21 Работает калибровка
2022-11-22 Компилируется, но вряд ли работает
2022-11-22 Компилируется с настройками. Не проверялось
2022-11-22 Кажись, настройки сохраняются
2022-11-22 Условно завершено с калибровками и настройками
2022-11-22 Кнопка сброса калибровок
2022-11-23 Теперь на постоянке нет знака при нулевых показаниях
2022-11-23 Сделано отключение логгирования
2022-11-23 Теперь сообщения в UART заканчиваются 0d0a
2022-11-23 Работает IDN?
2022-11-23 Работает *RST
2022-11-23 Работает RANGE
2022-11-23 Частично работает DATA?
2022-11-23 улучшена команда data?
2022-11-23 data? работает правильно
2022-11-23 обработка ошибок SCPI
2022-11-24 сделан RS232
2022-11-24 Updater - коннектится к устройству
2022-11-24 Добавлены файлы для Loader
2022-11-25 Готово к частичной проверке загрузчика - что он переходит на основную прошивку
2022-11-25 Загрузчик отрабатывает переход на основную прошивку
2022-11-25 Если Loader записан последним, то не запускается
2022-11-25 Коннектится к загрузчику
2022-11-25 Происходит запись принятой прошивки и передача управления на неё, но программа не работает
2022-11-25 Грязным трюком удалось заставить заработать обновление. Приходит первый лишний байт. Нужно найти и исправить
    [Commands.cpp, HAL_EEPROM.cpp, SCPI.cpp]
2022-12-20 исправлена калибровка
2022-12-22 Поменял местами диапазоны 20 и 50 А
2022-12-22 Исправлен баг с превращением 10 в 1
2023-03-09 ФАйлы wxWidgets заменены на 3.2.2.1
2023-03-09 Переход на wxWidgets 3.2.2.1
2023-09-18 Заготовки для кнопок
2023-09-18 Есть нажатие кнопки от дисплея
2023-09-25 Неправильно имя кнопки выделяет
2023-09-26 Отключена задержка на загрузчике
2023-09-26 Отключена проверка возвращаемого значения
2023-09-28 Теперь не глючит при переключении страниц - введена задержка, чтобы дисплей мог отработать
2023-09-28 Звёздочка на странице калибровки мигает
2023-10-02 На странице калибровки есть текущее измерение
2023-10-02 Пароль уменьшен до '1'
2023-10-02 Исправлен баг с мусором на экране при повторном открытии страницы калибровки
2023-10-02 Начинаем калибровку
2023-10-04 При переключении диапазонов, пока не получены новые измерения, выводятся звёздочки
2023-10-06 Индикация переполнения
2023-10-06 Сохранение калибровочных настроек
2023-10-09 Подправлена калибровка
2023-10-17 Кнопка МАКС в калибровке теперь всегда видна
2023-10-17 Кажется, работает подстройка нуля
2023-10-17 Работает калибровка кроме 20 А
2023-10-17 калибрует всё
2023-10-20 Откючение режимов zero при переключении диапазонов
2023-10-20 Будем переходить на double в измерениях
2023-10-24 Не работает кольцевой буфер на приёме
2023-10-24 Работает кольцевой буфер на приёме
2023-10-24 Не работает в режиме Debug
2023-10-24 Отрисовывается рамка кнопки
2023-10-24 Отрисовывается кнопка с надписью
2023-11-09 Почти компилируется vs_win
2023-11-09 Компилируется vs_win
2023-11-10 Не компилируется
2023-12-01 Возврат к размерности float
2023-12-04 refact struct BufferADC переделан в namespace. Не компилируется - не хватает памяти
2023-12-04 Компилируется
2023-12-04 Компилируется. Размеры стека и кучи подкорректированы
2023-12-04 Кажется, решён вопрос с неправильными показаниями после калибровки
2023-12-04 Теперь подкалибровка идёт после каждого переключения диапазона
2023-12-04 Теоретически исправлен баг с появлением вместо DC:, AC: неправильных символов
2023-12-05 v6 выбор типа измерений - float или double
2023-12-05 Теперь после переключения диапазона сбрасывается таймер подкалибровки
2023-12-26 Обновлена прошивка дисплея
2024-01-25 v7 - поменяли выводы US6 и US7
2024-01-30 Вернулось к работоспособному состоянию
2024-02-02 Добавлена временная кнопка для сброса
2024-02-02 Работает временная кнопка Reset
2024-02-02 Исправлен страшенный баг с сохранением настроек
    [HAL_EEPROM.cpp]
2024-02-07 пробуем увеличить время измерения в два раза для повышения точности
2024-02-09 Переполнение обозначается как положено
2024-02-11 Теоретически после включения поля измерений не должны быть пустыми
2024-02-21 Отключён загрузчик. Сейчас работает и релизная версия
2024-05-02 Ввод серйиного номера
2024-05-02 Улучшен ввод серийного номера
2024-05-14 Убраны звёздочки при подкалибровке. заблокированы нереализованные страницы. при включении должны выводиться единицы измерения
2024-05-14 Звёздочка мигает только на главной странице
2024-05-14 Звёздочка мигает при новом измерении, но не чаще 1 раза в секунду
2024-05-15 OL при перегрузке теперь по центру
2024-05-15 Команда IDN
2024-05-15 Теперь мы знаем, сколько измерений выводится на дисплей
2024-05-15 Реализована команда MEAS?
2024-05-15 Каркасы для команд I,J,IJ
2024-05-15 Каркас для команды ZI, ZJ
2024-05-15 Переключается предел по команде, но на экране не отображается
2024-05-15 Работает установка предела. Нет выбора измерений - AC, DC или оба
2024-05-15 Работают команды I, J, IJ
2024-05-16 реализованы команды установки нуля в SCPI
2024-05-16 Работает установка нуля
2024-05-16 Теперь точно работает установка нуля на переменке
2024-05-17 Устранён баг, когда после подкалибровки сбивались измерения. Теперь звёздочки на экране, которые нужно устранять
2024-05-17 Нет звёздочек при калибровке
2024-05-17 Теперь нормально измерения выводит
2024-05-17 Перегрузка вроде бы работает
2024-05-17 Правильно рассчитываются абсолютные значения
2024-05-17 Правильно работают НольAC/НольDC
2024-05-17 Пробуем избавиться от разных размерностей в измерениях
2024-05-17 Измерения корректно отображаются
2024-05-17 всё работает
2024-05-20 Заготовка для АВП
2024-05-20 Можно приступать к АВП
2024-05-20 Работает АВП, но не отображается на экране
2024-05-20 Рабочая версия
2024-05-21 При переключении диапазона нули отключаются
2024-05-21 Диапазон АВП разбит на два
2024-05-21 Кажется, разобрались с АВП
2024-05-21 Документация
2024-05-22 Стал лучше работать SCPI - на 180 мс
2024-05-22 Лучше не становится. 170 мс
2024-05-22 Очередная версия на испытания с замечаниями от 21.05.24
2024-05-27 При включении нуля из режима АВП теперь подсвечивается выбранный режим
2024-05-27 метки нуля, информации о приборе не выключаются самопроизовльно
2024-05-30 Обновление прошивки дисплея. Добавлены Backspace, сделано сохранение яркости. Заготовка для сохранения установленного языка
2024-05-30 Версия от 29 мая отправлена в архив
2024-05-30 Теперь не глючит ноль DC
2024-05-30 После выхода из калибровки предел сохраняется
2024-05-30 Кнопка Backspace скрывается,, так же как и остальные
2024-05-30 Backspace работает
2024-05-30 Всё сделано, но зависает при выходе из страницы настроек
2024-05-30 Убран лишний вывод из дисплея. Сейчас должно реже глючить выход из настроек
2024-05-31 Выводится среднее после нуля АЦП
2024-05-31 Выводим АЦП
2024-06-14 Отключен АВП на 20А, 50А
2024-06-14 Кажется работает подстройка нуля на 20А, 50А
2024-06-14 Улучшено переключение на диапазоны 20А, 50А
2024-06-14 Убрали отладочный вывод, исправлен Zero DC
    [Ampermeter.cpp, Ampermeter_settings.cpp, BufferADC.cpp]
2024-08-14 Коррекция прошивки дисплея
2024-08-15 Коррекция дисплея
2024-08-19 Готовимся к вычислению Imin
2024-08-20 wxWidgets обновлена до 3.2.5
2024-08-20 Добавлен скрипт для управления версиями
2024-08-20 Работает version_inc.py
2024-08-21 Засылаются дополнительные измерения, но не вычисляются
2024-08-21 Выводит минимальное значение, только без знака
2024-08-21 Выводятся знаки дополнительных измерений
2024-08-21 Сделаны три дополнительных измерения, но на последних трёх приделах пик-то-пик неправильно показывает
2024-08-21 Теперь пик-ту-пик тоже правильно показывает
2024-08-21 мин, макс, пик показывает, но, кажется, неправильно
2024-08-21 Теперь правильно измеряет мин-макс
2024-08-21 Не работает измерение амплитуды на 20 и 50 А
2024-08-21 GUI компилируется
2024-08-21 Заготовка для Flahser
2024-08-21 Делаем Flasher
2024-08-23 Начинаем программную кнопку
2024-08-23 Удалены из дисплея кнопка 2 мА и метки АВП
2024-08-23 Программная кнопка получается такая же, как и на дисплее
2024-08-26 план
2024-08-26 Принимаются сообщения от тачскрина
2024-08-26 Работает функция кнопки диапазона, но не работает реакция ГУИ на неё
2024-08-26 Вроде бы реагирует на нажатие, но подключивает
2024-08-26 Кнопка 2 мА отрабатывает правильно
2024-08-26 Висит на кнопке 2А почему-то
2024-08-26 Виснет при переключении на 2А
2024-08-28 Ускорена отрисовка кнопки
2024-08-28 Исправлен баг с вылетом на нажатии 2А
    [MenuItems.cpp, defines.h]
2024-08-28 Координаты перешли с int на int16
2024-08-28 Ускорена отрисовка кнопкиexit
2024-08-28 Переделаны кнопки всех диапазонов и Уст0
2024-08-28 Работает первая версия метки -ноль-
2024-08-28 Работает программные метки -ноль-
2024-08-28 Label локализована
2024-08-29 Модернизировано поведение кнопки Уст0
2024-08-29 Не работает отображение единиц измерения
2024-08-29 Нормально выводятся единицы измерения
2024-08-29 Теперь все элементы, отображаемые на экране, будут наследоваться от Item
2024-08-29 Не работает после рефаткоринга
2024-08-30 Заготовлено место в настройках для фиксации включённого состояния дополнительных измерений
2024-08-30 refact Не показывает единицы измерения
2024-08-30 Из прошивки дисплея убраны поля измерений. Не работает
2024-08-30 Начинаем делать новое поле для измерения
2024-08-30 Не висит, но вывод измерений ещё не реализован
2024-08-30 Готовимся к выводу измерений
2024-09-01 Собираются GUI-версии
2024-09-01 В GUI-версии работают кнопки переключения диапазонов
2024-09-02 Выводятся прямоугольники на месте LabelMeasure
2024-09-02 Все поля измерений выводятся на главной странице
2024-09-02 Введены поля для названия измерений, но экран страшно глючит - всё время перерисовываетя
2024-09-02 Не работает конструктор копирования Label
2024-09-03 Не вылетает на создании Label@
2024-09-03 Должно отображаться название измерения, но не отображается
2024-09-03 работает отключение WindowMeasure
2024-09-03 Добавлен отладочный вывод границ полей измерений
2024-09-03 Поля измеерний отцентрованы по вертикали
2024-09-05 Продолжаем переносить кнопки в прошивку stm32
2024-09-05 Осталось страницу калибровки перенести в основную прошивку
2024-09-05 Теперь stm32 будет управлять всем отображением на экране, за исключением стартовой страницы
2024-09-05 Устанавливается 2А при включении
2024-09-05 работает ButtonToggle
2024-09-09 Выводит измерения
2024-09-09 Выводится два элемента меню - Настройки и Система
2024-09-10 Теперь диапазоны лучше переключаются
2024-09-10 В функцию нажатия добавлен признак нажатия/отпускания
2024-09-10 В меню будет три столбика по 5 элеметов в каждом
2024-09-10 Работает кнопка у Choice
2024-09-10 Работает кнопка в Choice
2024-09-10 Добавлена кнопка для настроек COM-порта
2024-09-10 теперь в Choice's загружаются значения из настроек
2024-09-10 Заготовка для страницы ИНФОРМАЦИЯ
2024-09-11 Страница информации
2024-09-11 Работает ввод серийного номера
2024-09-11 Можно зайти на страницу графиков. Графики не отображаются
2024-09-11 Добавлена форма для графиков в прошивку дисплея
2024-09-11 Вывод графика
2024-09-11 Ускорен вывод графиков
2024-09-11 Переделаны кнопки выбора графиков
2024-09-11 Добавлены кнопки яркости, амперметр измеряет только когда нужно
2024-09-11 По идее ещё ускорилось
2024-09-12 Не работает установка яркости
2024-09-12 Работает установка яркости
2024-09-12 Исправлена отрисовка серийного номера
    [defines.h]
2024-09-12 Добавлены большие шрифты
2024-09-12 Увеличен размер шрифта главных измерений до 144
2024-09-12 Зависает при переключении на меню
2024-09-12 На главном экране есть все кнопки кроме АВП
2024-09-12 Верхний ряд кнопок на главной странице
2024-09-12 Более менее работают дополнительные измерения
2024-09-12 Сбрасываются показания измерений при переключении диапазона
2024-09-12 Теперь при нажатии на кнопку текущего диапазона она не отжимается
2024-09-12 Работает переключение AC/DC
2024-09-12 Переключается положение AC/DC на экране
2024-09-12 Кнопики Нуль AC/DC отщёлкиваются при переключении диапазона
2024-09-12 Кнопки включения/отключения дополнительных измерений корректно отрабатывают.
2024-09-13 Прошивка дисплея маленько исправлена в части скорости
    [defines.h]
2024-09-17 Исправлена отрисовка кнопок в нажатом состоянии
    [MenuItems.cpp, defines.h]
2024-09-17 АВП работает, но состояние кнопок диапазонов не меняется
2024-09-17 Должен работать выбор типа главных измерений
2024-09-17 Устанавливается главное измерение при запуске
2024-09-17 Кажется, АВП щёлкает как положено
2024-09-17 Реализованы настройки меню COM-порт
2024-09-17 Продолжаем включать страницу калибровки
2024-09-17 Не зависает при включении страницы калибровки
2024-09-17 Не работает калибровка
2024-09-18 Вся функциональность перенесена в stm32
2024-09-18 Восстановлена работоспособность
2024-09-18 Выровнено положение измерений на странице калибровки
2024-09-18 Устанавливается требуемое значение тока на странице калибровки
2024-09-18 Глючит отрисовка чёрнго поля на странице клавиатуры калиброки
2024-09-23 Увеличена высота зоны срабатывания для мелких кнопок главного окна в два раза
2024-09-23 detrash. Готовимся к показу звёздочки на экране
2024-09-23 Мигает звёздочка на главном экране
2024-09-25 Теперь нельзя установить ноль для измерения, которого нет на экране
2024-09-25 Единицы измерения на амперах соотвтствуют
2024-09-27 Работает калибровка нуля
2024-09-27 Частично работает переключение языка
2024-09-27 Работает переключение языка
2024-10-07 Единицы измерения частоты подключены
2024-10-08 Частота нормально выводится
2024-10-08 Готовимся к измерению частоты
2024-10-08 Первое измерение частоты. Меряет 6 Гц. Видимо, неправильно
2024-10-08 Продолжаем расчёт частоты
2024-10-08 Единицы измерения отсутствуют при отстуствии частоты
2024-10-10 При возвращении из Меню ненужный НУЛЬ не отображается
2024-10-10 Работает увеличенный размер мелких кнопок при фиксации, но в меню полный бардак
2024-10-11 Устранён баг при заходе в меню
2024-10-11 меню подправлено
2024-10-11 Убрали автоматический выбор диапазоно
2024-10-11 Не работает переключение языка
2024-10-11 язык не переключается
2024-10-11 Исправлен баг с Choice
    [MenuItems.cpp, MenuItems.h, defines.h]
2024-10-11 Стек увеличен до 103 кБ. Всё работает
2024-10-15 Затенение неактивных пунктов меню
2024-10-15 Очень медленно считает частоту
2024-10-15 Добавлен медианный фильтр по трём
2024-10-15 Удаляем из ResolverFrequency все упоминания об интегралах
    [defines.h]
2024-10-15 Будет искать по касательным
2024-10-15 Что-то из частоты считает, но неправильно
2024-10-15 Работает расчёт частоты
2024-10-15 Работает расчёт частот
2024-10-15 Исправлен баг в Averager
    [defines.h]
2024-10-16 Улучшено измерение частоты, но ещё не измеряет 40 Гц
2024-10-16 Не считает частоту, похоже
2024-10-17 Множественное чтение точки добавлено
2024-10-17 Кажется, нормально считает после переделки
2024-10-17 Нажатие кнопки вызывает прерывание процесса измерения
2024-10-17 Калибровка восстановлена
2024-10-17 Исправлена кнопка в калибровке
    [defines.h]
2024-10-22 Добавлена кнопка сброса настроек
2024-10-22 Рисуется координатная ось в сигнале
2024-10-22 Кажется, рисуется график
2024-10-22 Должна работать отрисовка входного сигнала
2024-10-25 Исправлен баг со сбросом заводского номера при выключении на меню ИНФОРМАЦИЯ
    [defines.h]
2024-10-25 Теперь пароль 2700500
2024-10-26 Компилируется win-версия
2024-10-26 Компилируется и собирается всё
2024-10-26 Запускается win-версия
2024-10-26 На 4,5 диапазоне нет АВП
2024-10-26 На виндовс инициализируются цвета перед конструктором Label
2024-10-26 Рефакт
2024-10-26 В частоте осталось 3 цифры
2024-10-26 При перегрузке частота показывает ****
2024-10-26 Частоту показывает только при 10% от максимального AC
2024-10-26 Серийный номер со страницы калибровки убран, т.к. это оказался не серийный номер, а контрольная сумма
2024-10-26 Чёрная полоса на странице калибровки смещена вверх, чтобы глюбов не было видно
2024-10-26 По идее nan-ов больше не должно быьть
2024-10-26 Пофикшено измрение частоты
2024-10-26 Теперь везде I амп написано
2024-10-26 refact. Сигнал должен рисоваться при выходе за пределы
2024-10-26 На win-версии рисуется сигнал, хоть и неправильно. 2
2024-10-26 Правильно работает программная генерация в win
2024-10-26 Правильно рисуется входной сигнал
2024-10-26 refact Sample Rage
2024-10-26 Начинаем переключение диапазона
2024-10-26 Теперь кнопка АВП видна после включения
2024-10-26 Должно работать переключение частотного диапазона
2024-10-26 Работают информационные сообщения о выходе частоты за пределы диапазона
2024-10-26 Исправлены ошибки в измерении частоты
    [Ampermeter.cpp, Ampermeter.h, Calculator.cpp, defines.h]
2024-10-26 Теперь линия вренени рисуется только на главной странице
2024-10-26 У частоты теперь три значащих цифры
2024-10-26 Подправлены измерения мин макс пик, амплитуда, но, скорее всего, неправильно
2024-10-26 Всё собирается
2024-10-26 Странно считает амплитудные значения
2024-10-26 Условно закончили с дополнительными измрениями
2024-10-26 Пофикшен вылет на win при переключении языка
2024-10-27 Готовимся к отображению FFT
2024-10-27 Не работает отрисовка FFT
2024-10-27 Работает отображение спепктра
2024-10-27 Окно хэмана добавлено
2024-10-27 Спектр ближе к делу похож
2024-10-27 Показывает спектр по хэммингу
2024-10-27 Добавлены другие окна
2024-10-27 Отображение спектра условно закончено
2024-10-27 Распарсена команда UPGRADE
2024-10-27 Версия прошивки расположена по адресу 4к
2024-10-28 Количество точек уменьшено до 4096
2024-10-28 Удалили диапазон и графики из меню
2024-10-28 Предупреждения о выходе частоты выводятся
2024-10-28 Оставили на всякий случай графики
2024-10-28 Исправлен баг в расчёте спектра
    [defines.h]
2024-10-28 Исправлено считывание с АЦП
    [Ampermeter.cpp, defines.h]
2024-10-28 Отключены графики
2024-10-28 Измерения сделаны теоретически
2024-10-28 Не выводится кривое измерение в Iamp
2024-10-28 Работает Iampl
2024-10-28 Количество точек для расчёта Iамп уменьшено до 5тыс
2024-10-28 Последние изменения перед отправкой в белгиз
2024-10-28 Исправлен баг 010.00 на 20 мФ
    [defines.h]
2024-10-28 Теперь Iамп всегда показывает
2024-11-11 Восстановление кнопок меню - диапазон, график
2024-11-11 Ускорено переключение вида графика
2024-11-11 Надписи на диапазонах
2024-11-12 Кнопки АВП и УСТ 0 занимают одно и то же место на экране
2024-11-12 Идёт отсчёт секунд на длинных развёртках
2024-11-12 Скорректировано изображение при выходе из меню на длинных развёртках
2024-11-12 Звёздочка мигает
2024-11-13 Кнопка переключения AC/DC графика
2024-11-13 Кнопка выбора сигнала AC/DC отрабатывает внешний вид
2024-11-13 Можно инсталлировать сигннал АС для отрисовки
2024-11-13 Делаем шкалу
2024-11-14 Продолжаем рисовать АС в окне
2024-11-15 Продолжаем делать растяжку АС
2024-11-18 Первая версия вывода графика АС
2024-11-18 Условно работает первая версия
2024-11-18 синус выводит правильно
2024-11-18 нормально выводит граничные значения, но на 2 А и более при нуле неправильно показывает
2024-11-18 предварительно завершено
2024-11-18 Начинаем утилиту для создания прошивки
2024-11-26 Улучшен расчёт частоты
2024-11-27 Графики лучше выводятся
2024-11-27 Правильно выводятся пределы по АС
2024-11-27 Правильно на графике подписана отрицательная постоянная составляющая
2024-11-27 Готовимся к передаче в дислей по прерыванию
2024-11-27 Готово к передаче по прервываниям в дисплей
2024-11-27 Работают длинные времена
2024-11-27 Убраны поправки из расчёта частоты
2024-12-05 Не индицируется частота при амлпитуде меньше 10% от масимуму
2024-12-05 Сделана индикация по диапазону. Готово к сдаче
2024-12-09 Попытка добавления команды R?. Не работают все команды
2024-12-09 Добавлены команды частотного диапазона
2024-12-18 Комментарии
2024-12-19 Исправлена команда "D?"
2024-12-19 Русифицирована страница вывода сигналов
2024-12-20 Исправлен баг Language на английском языке
    [HAL_TIM4_win.cpp, HAL_USART2_win.cpp, MenuItems.cpp, MenuItems.h]
2025-02-12 Изменена полярность бита US9
2025-02-13 Вернулись на старую версию компилятора 6.18 - на 6.21 были зависания
2025-02-25 Ограничена яркость до 80%
2025-05-02 Пробуем подправить калибровку
2025-06-26 Исправлен баг калибровки, когда при калибровке откалиброванного прибора калибровка не работает
    [defines.h]
2025-06-27 Поправление калибровки
2025-06-27 Наверное, убраны зависания. Их наверное, нет на компиляторе 6.18
2025-06-27 Переход на компилятор 6.18 - на нём не виснет переключение на диапазон 20 А
2025-06-27 Добавлены volatile. Возможно, это избавит от зависания на компиляторах выше 6.18
2025-06-27 Продолжаем мучать калибровку
2025-06-27 Попытка исправить измерения
2025-08-05 Возврат к версии 539, когда не трогали калибровку
2025-08-05 Исправлен баг с неправильными мин/макс
    [BufferADC.cpp, BufferADC.h]
2025-08-05 Увеличено время измерения на 10%, чтобы избавиться от скачков измерения на 5кГц
2025-08-05 Знак у измерения другой
2025-08-06 Возврат к версии 554
2025-08-07 Кажется, решена проблема неправильного знака измерений
2025-08-14 В очередной раз исправлена калибровка
2025-08-14 ИСправлен баг с прыжком измерений
2025-08-15 Сделан сброс калибровочного коэффициента перед калибровкой нуля
2025-08-26 Версия для первых 17 приборов
2025-10-20 Предположительно пофикшена команда MEAS?
2025-10-20 Работает MEAS?
2025-10-30 Исправлены команды zi0, zi1, zj0, zj1
2025-11-07 Файлы wxWidgets заменены на версию 3.3.1
2025-11-07 Компилируется A101-GUI
2025-11-07 Все win-проекты собираются
2025-11-07 Восстановлена работоспособность win-проектов
2025-11-12 Теперь происходит прыжок из загрузчика в основную программу
2025-11-12 Дату сборки тоже разместили в памяти
2025-11-12 GUI bootloader считывается и выводится информация о файле
2025-11-12 Готовимся получать порты
2025-11-12 Подключение к порту работает
2025-11-13 Устанавливается связь с А101
2025-11-13 Предварительно закончено на стороне ПК
2025-11-13 Keil подготовка к обновлению прошивки
2025-11-13 Правильные настройки прошивки для Device Debug
2025-11-13 Должен работать запись новой прошивки в ПЗУ
2025-11-13 stm32 принимает данные обновления
2025-11-13 Принимается вся прошивка
2025-11-13 Записывает прошивку в память и перезапускает прибор
2025-11-13 Теоретически обновление полностью закончено
2025-11-13 работает обновление
2025-11-13 Готово
2025-11-13 Вроде бы всё собирается без зависимостей
2025-11-18 Добавлена подсказка о скорости COM-порта
2025-11-21 Переход на Visual Studio 2026
2025-12-15 Попытка исправить баг с неустановкой нуля на 20A, 50A при выходе из меню на главную страницу
    [Ampermeter.cpp, Ampermeter.h]
2026-01-27 Исправлена калибровка диапазонов 20А, 50А
    [Ampermeter.h, Ampermeter_settings.cpp]
2026-02-02 Номер версии отображается на экране входа в калибровку
